m-scasserra/TrabajoFinal_MIoT/Hardware/LoRa-Monitor/3D Models/TYPE-C-31-M-12--3DModel-STEP-56544.STEP

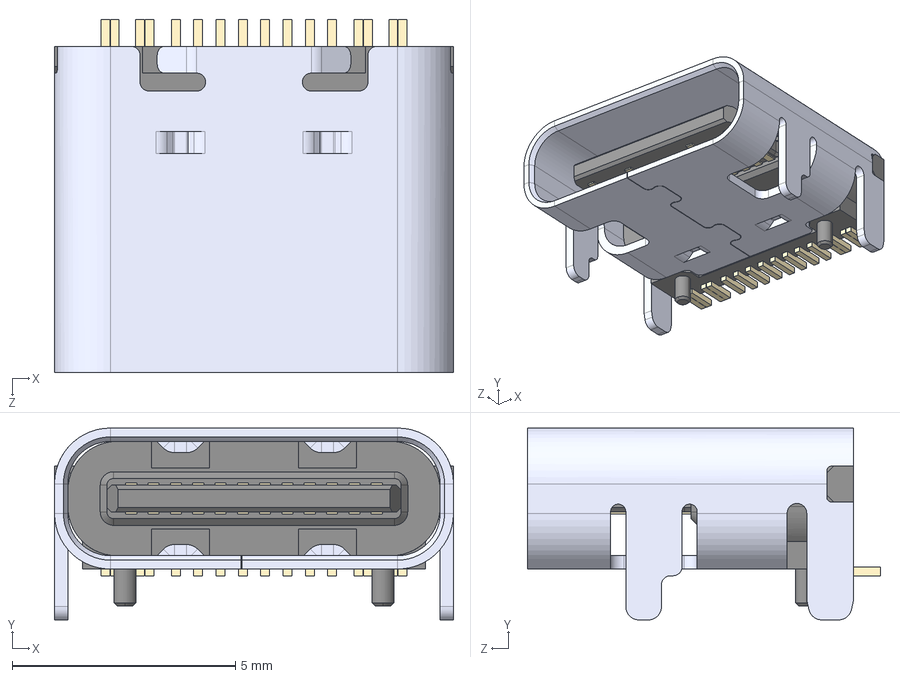
[picture p1: CAD file, 2026-07-15]
Hardware/LoRa-Monitor/3D Models/TYPE-C-31-M-12--3DModel-STEP-56544.STEP
8.94 x 4.30 x 7.90 mm
