m-scasserra/TrabajoFinal_MIoT/Hardware/LoRa-Monitor/3D Models/WE-GF_1210_2+%28rev1%29.stp

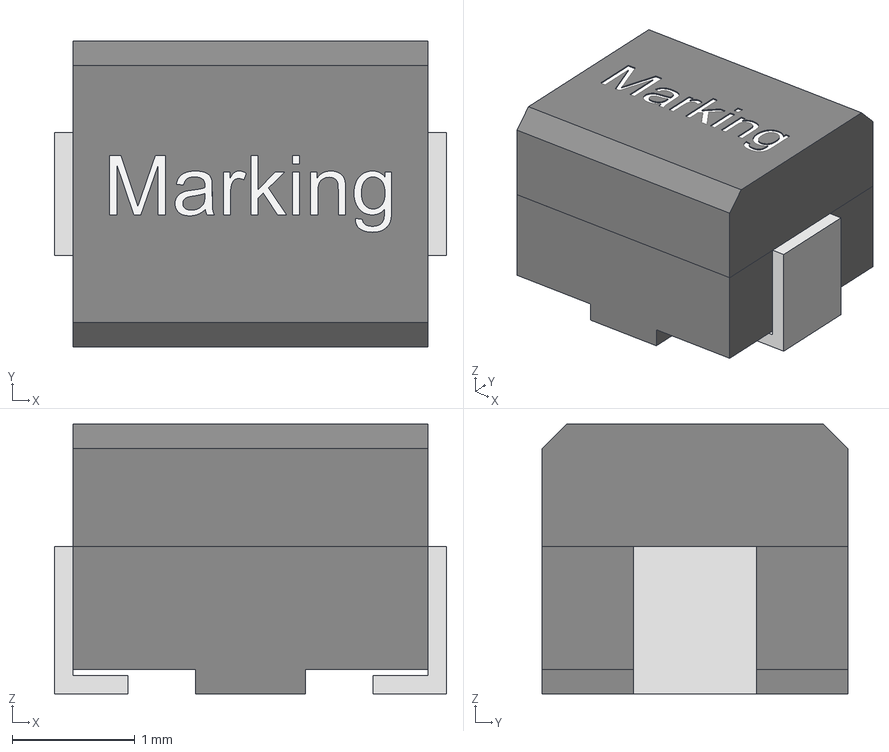
[picture p2: CAD file, 2026-07-15]
Hardware/LoRa-Monitor/3D Models/WE-GF_1210_2+%28rev1%29.stp
3.20 x 2.50 x 2.20 mm
Gehäuse
PIN
Deckel
