m-scasserra/TrabajoFinal_MIoT/Hardware/LoRa-Monitor/3D Models/SK6812MINI-012.step

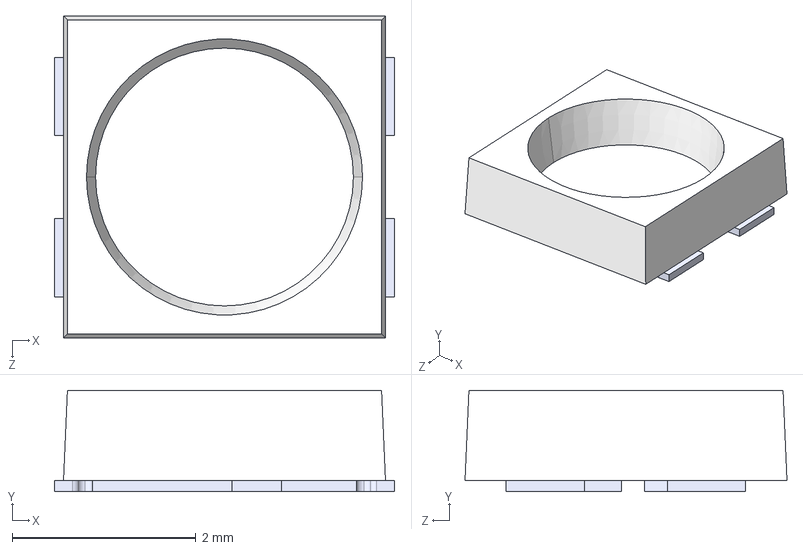
[picture p3: CAD file, 2026-06-10]
Hardware/LoRa-Monitor/3D Models/SK6812MINI-012.step
3.70 x 1.10 x 3.50 mm
