m-scasserra/TrabajoFinal_MIoT/Hardware/LoRa-Monitor/3D Models/E22-900M30S.step

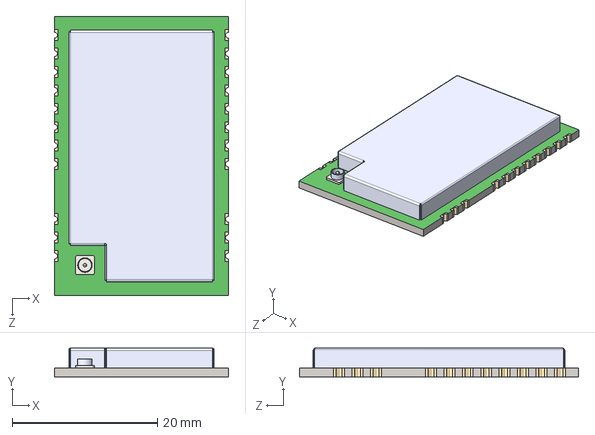
[picture p4: CAD file, 2026-06-10]
Hardware/LoRa-Monitor/3D Models/E22-900M30S.step
24.0 x 3.97 x 38.5 mm
