m-scasserra/TrabajoFinal_MIoT/Hardware/LoRa-Monitor/3D Models/ATM90E32AS-AU-R.step

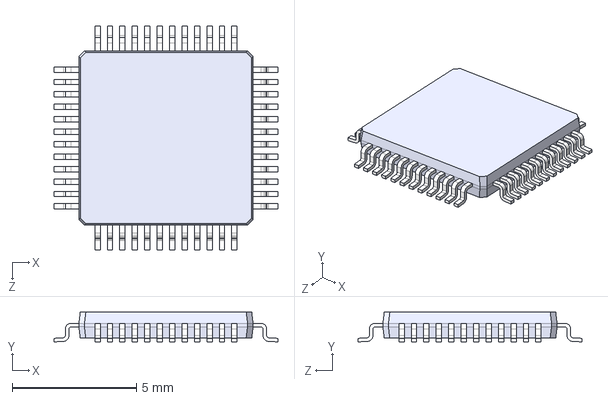
[picture p5: CAD file, 2026-06-10]
Hardware/LoRa-Monitor/3D Models/ATM90E32AS-AU-R.step
9.00 x 1.20 x 9.00 mm
