m-scasserra/TrabajoFinal_MIoT/Hardware/LoRa-Monitor/3D Models/IRM-05-5--3DModel-STEP-56544.STEP

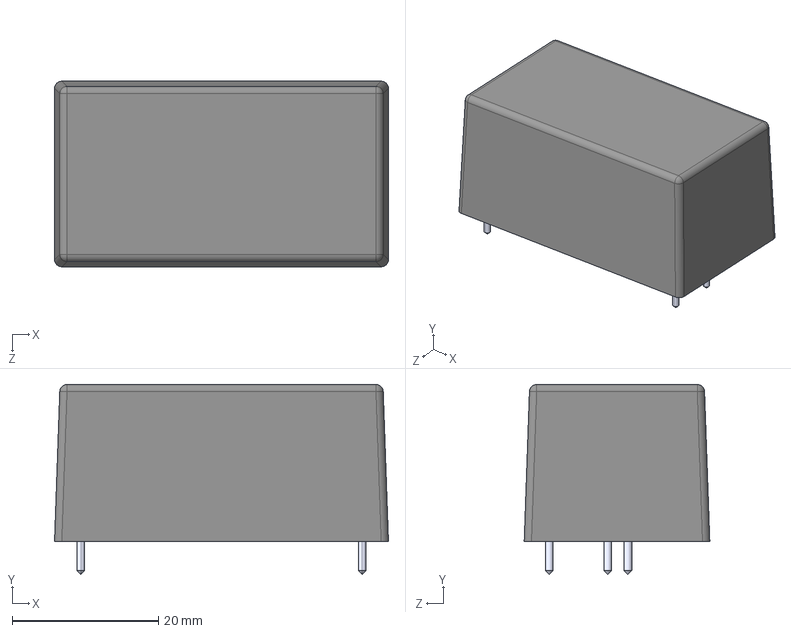
[picture p6: CAD file, 2026-06-09]
Hardware/LoRa-Monitor/3D Models/IRM-05-5--3DModel-STEP-56544.STEP
45.7 x 26.0 x 25.4 mm
