m-scasserra/TrabajoFinal_MIoT/Hardware/LoRa-Monitor/3D Models/472192001.stp

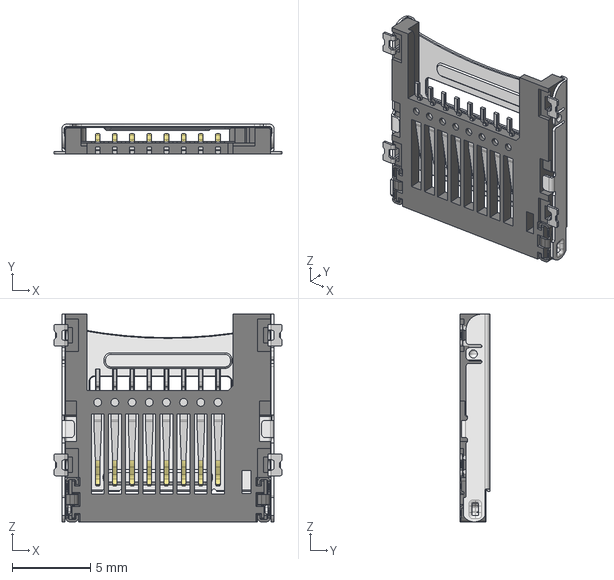
[picture p7: CAD file, 2026-07-15]
Hardware/LoRa-Monitor/3D Models/472192001.stp
14.6 x 1.90 x 13.3 mm
