m-scasserra/TrabajoFinal_MIoT/Hardware/LoRa-Monitor/3D Models/734120110.stp

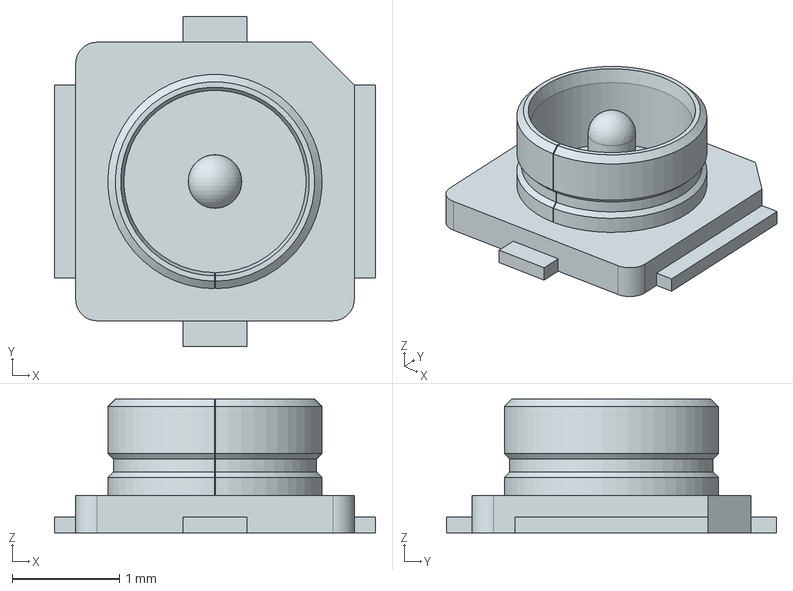
[picture p8: CAD file, 2026-07-15]
Hardware/LoRa-Monitor/3D Models/734120110.stp
3.00 x 3.08 x 1.25 mm
