m-scasserra/TrabajoFinal_MIoT/Hardware/LoRa-Monitor/3D Models/TPS63021DSJR.step

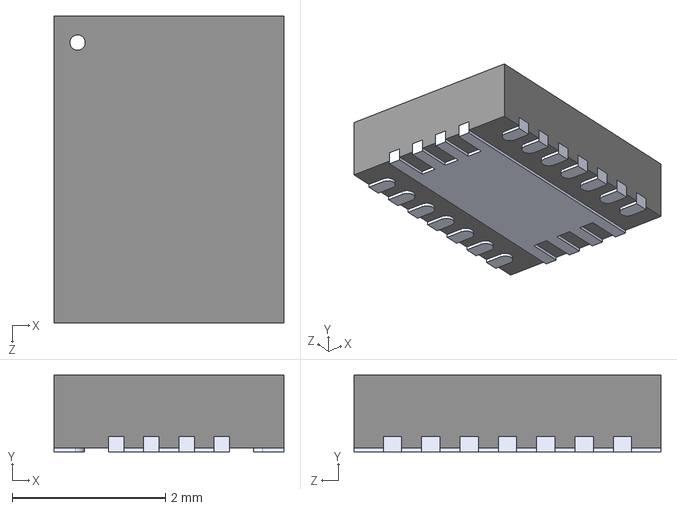
[picture p9: CAD file, 2026-06-09]
Hardware/LoRa-Monitor/3D Models/TPS63021DSJR.step
3.00 x 1.00 x 4.00 mm
