m-scasserra/TrabajoFinal_MIoT/Hardware/LoRa-Monitor/LoRa-Monitor.pdf

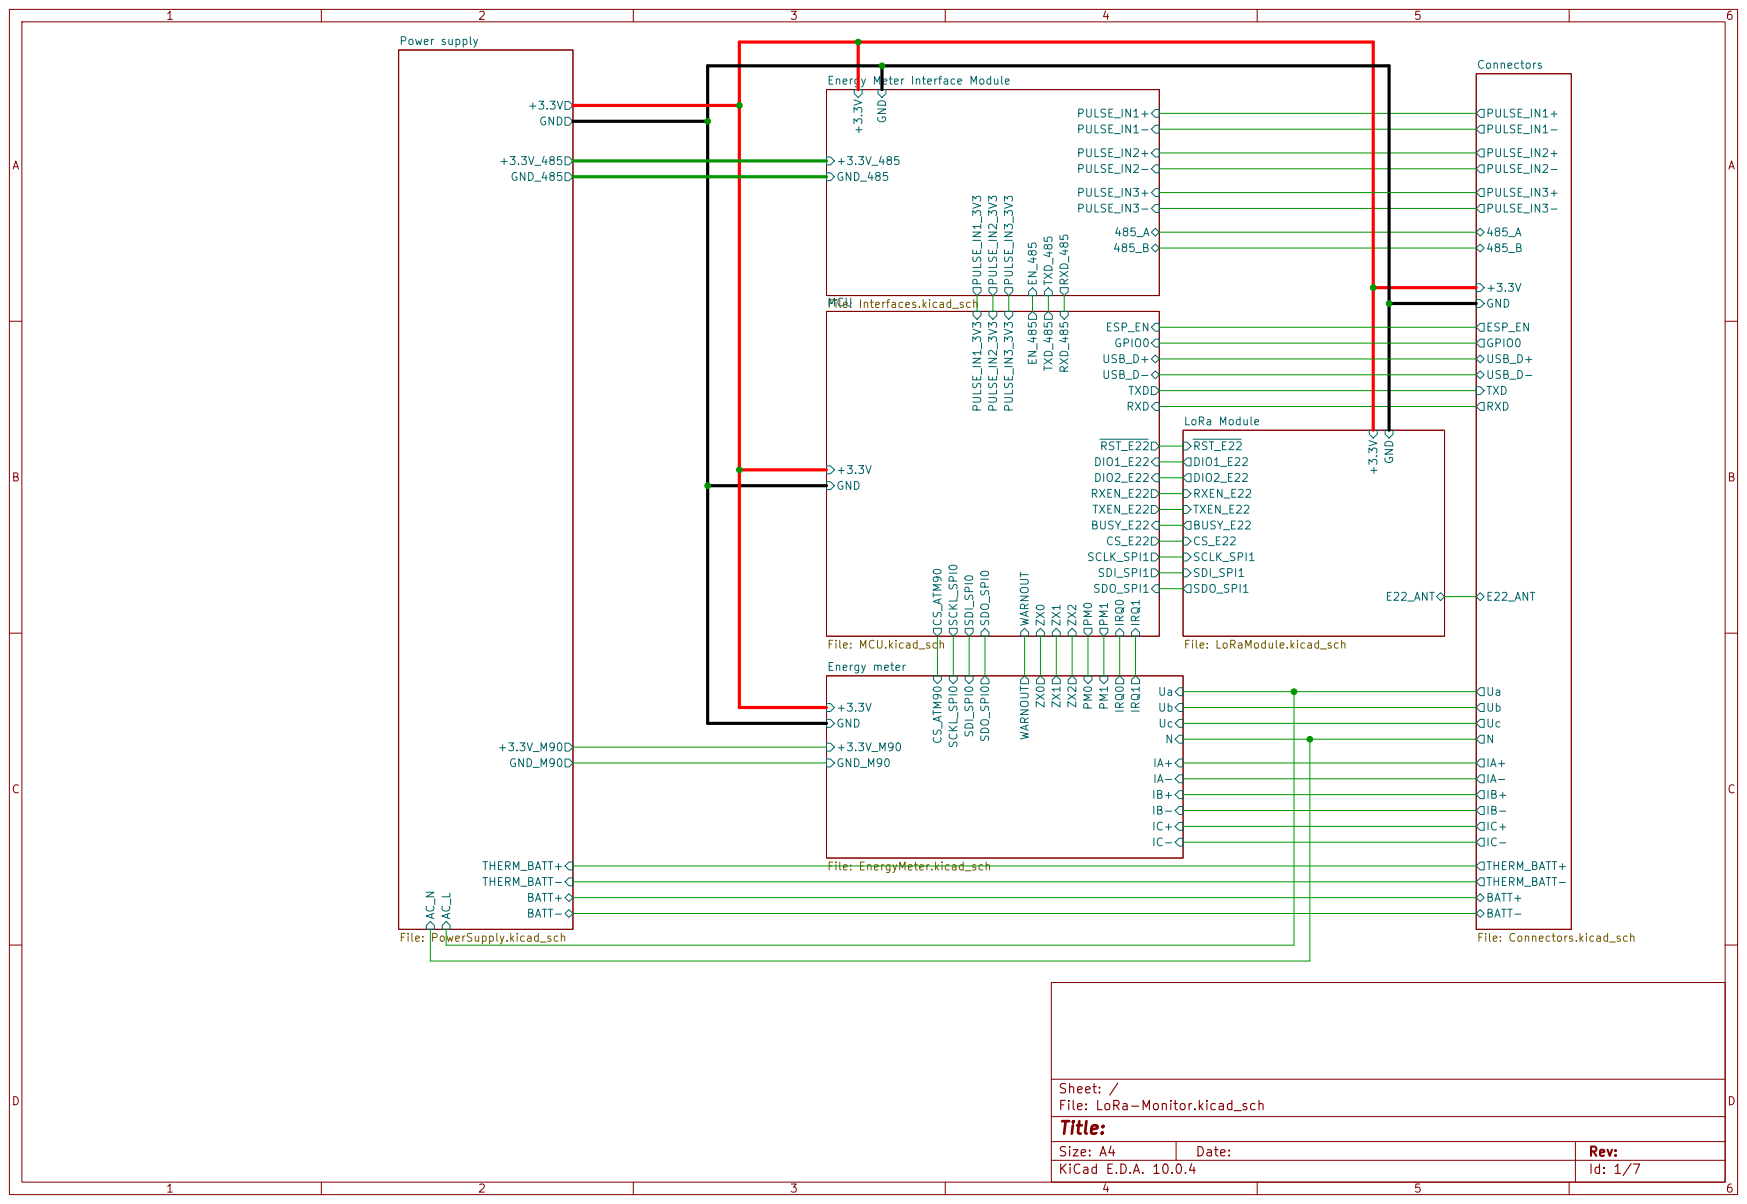
[picture p10: page 1]

Energy Meter Interface Module

Energy meter File: EnergyMeter.kicad_sch

Size: A4 | Rev:
KiCad E.D.A. 10.0.4 | Id: 1/7

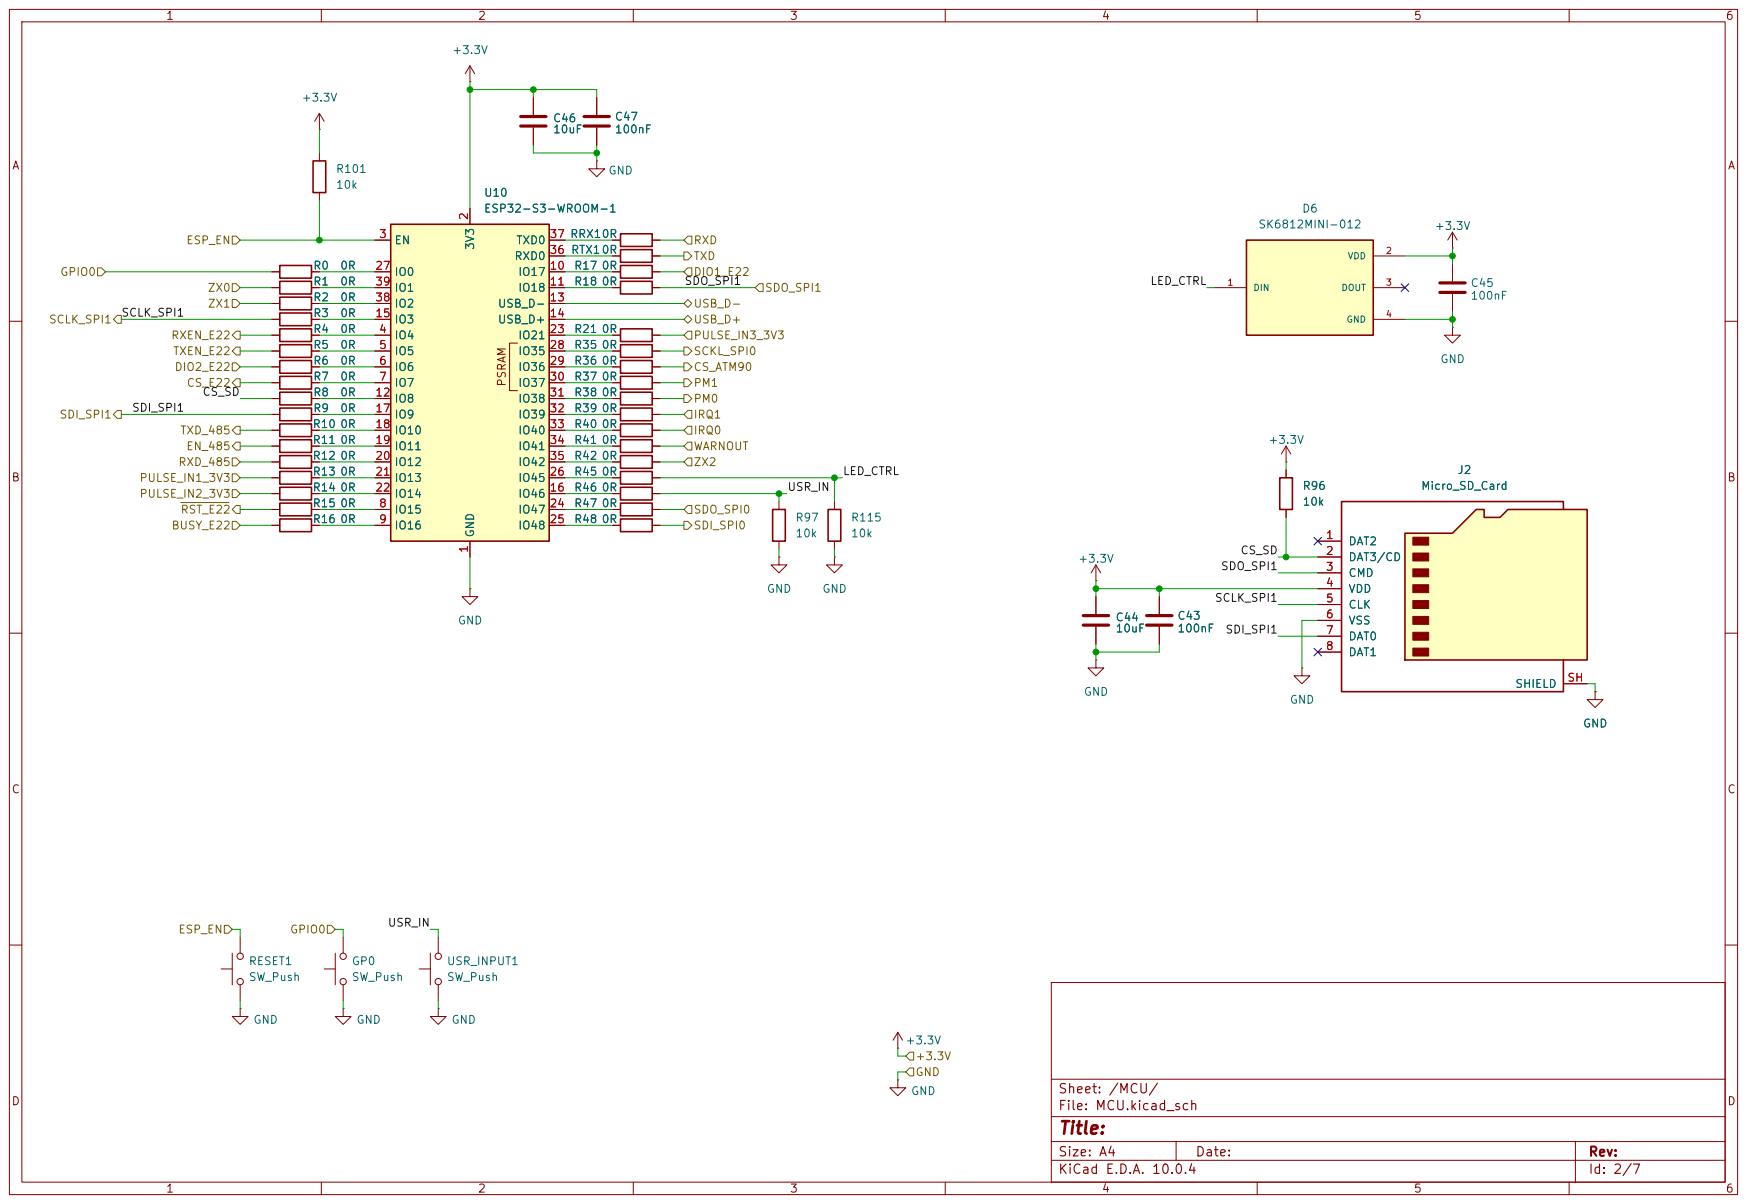
[picture p11: page 2]

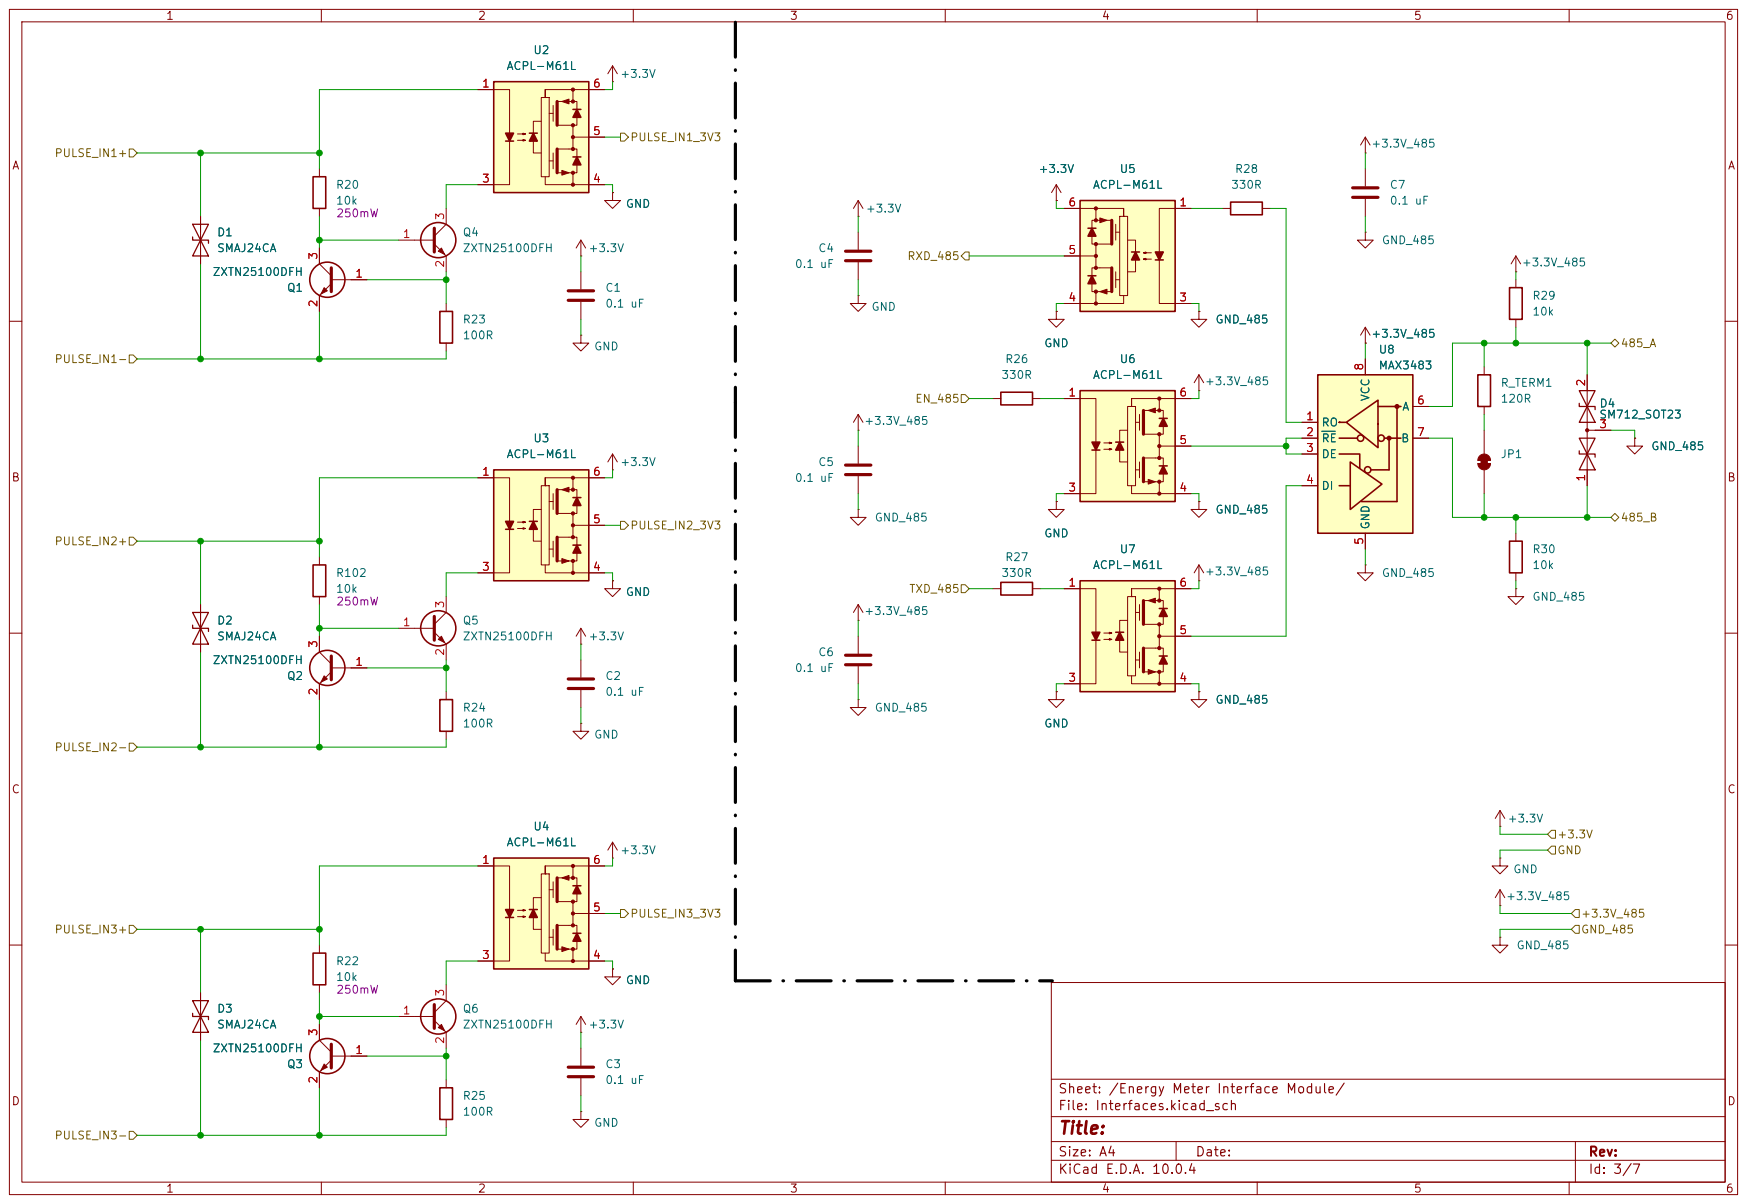
[picture p12: page 3]

Sheet: /Energy Meter Interface Module/
File: Interfaces.kicad_sch
Title:

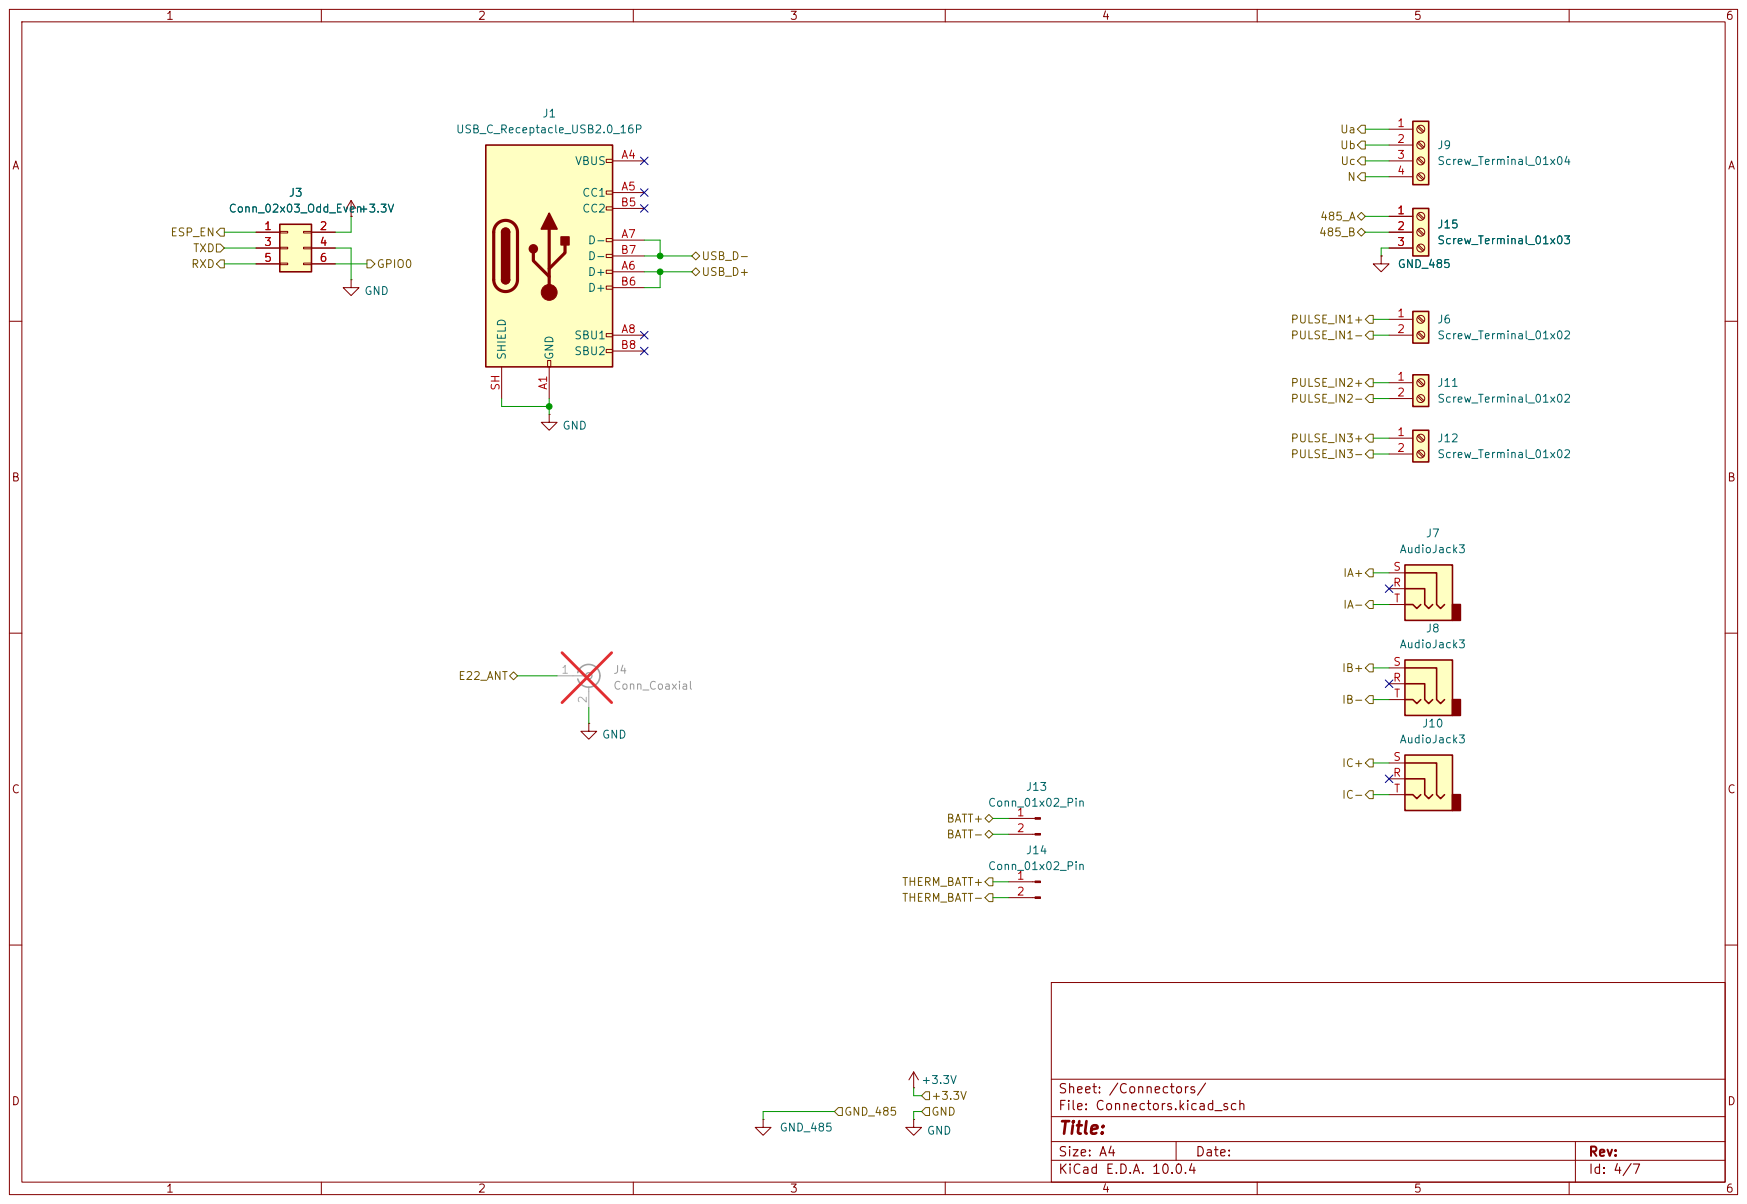
[picture p13: page 4]

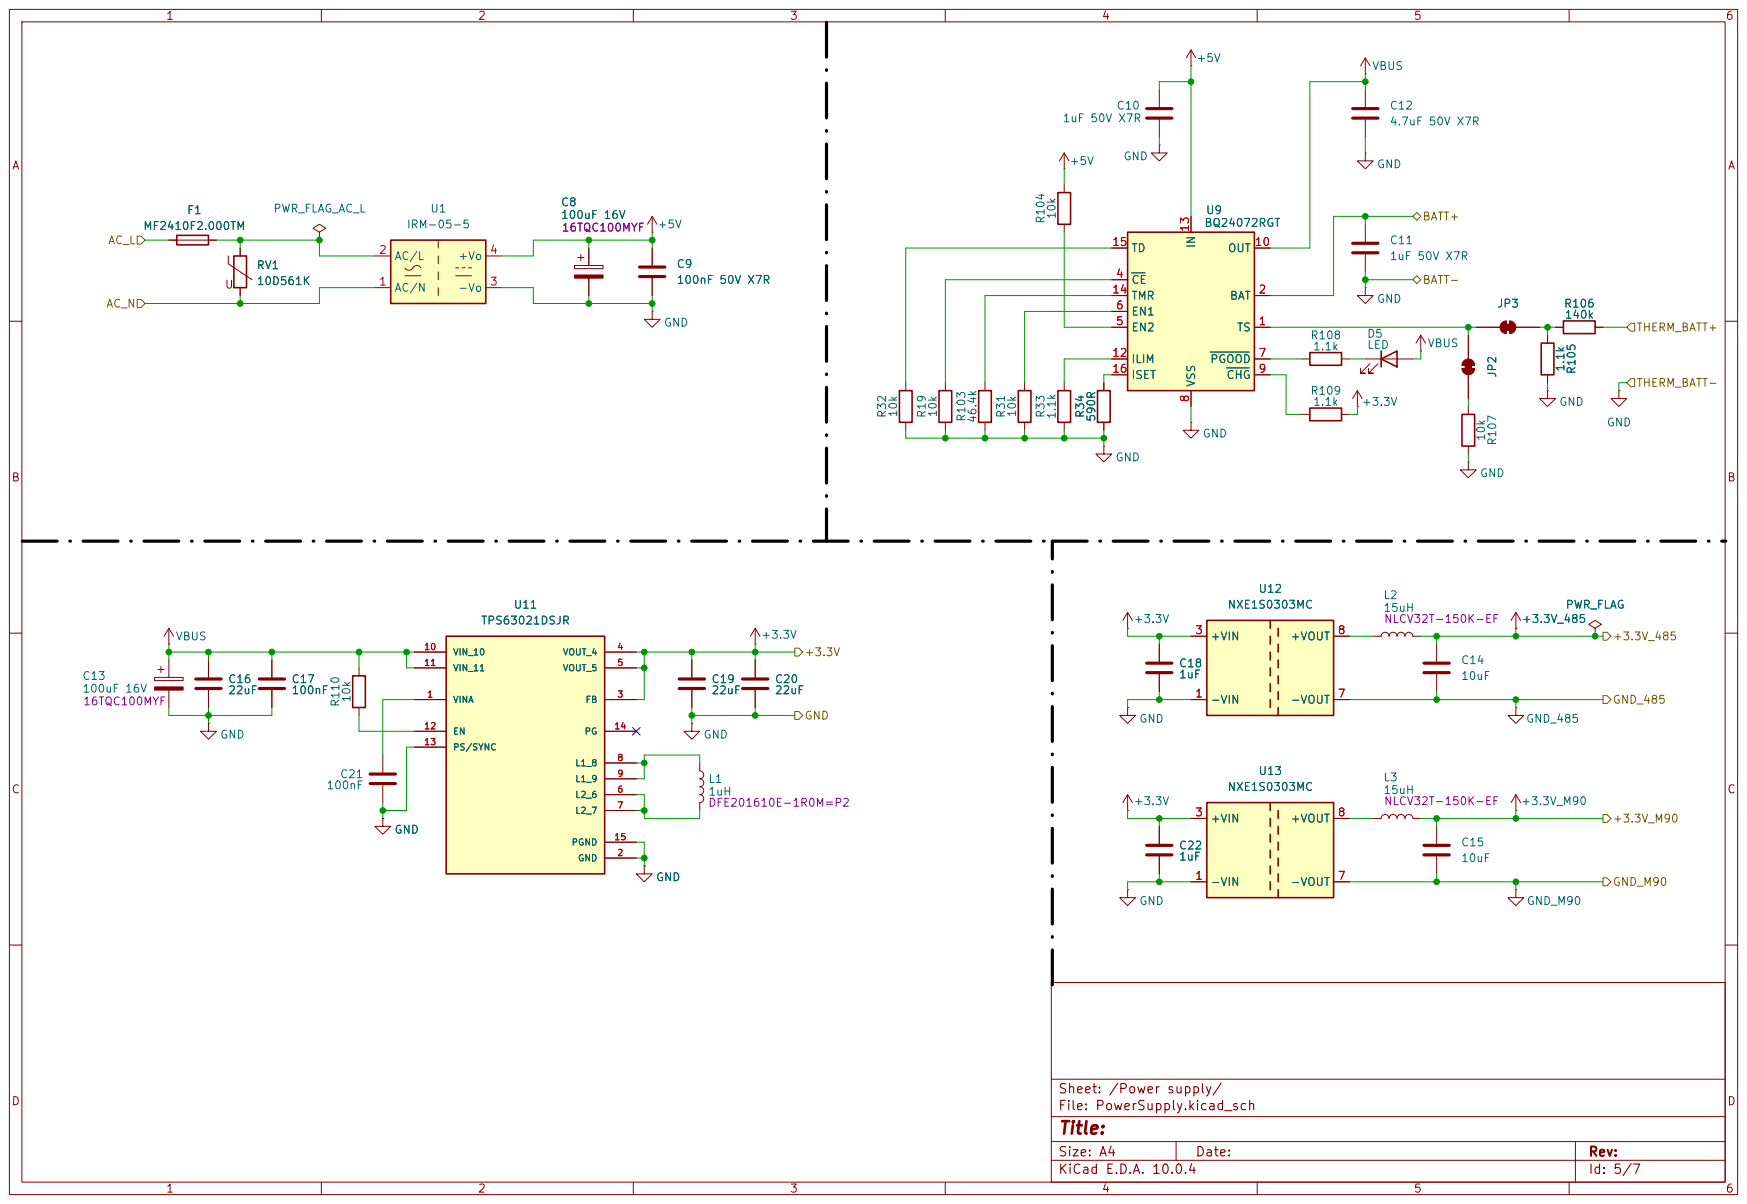
[picture p14: page 5]

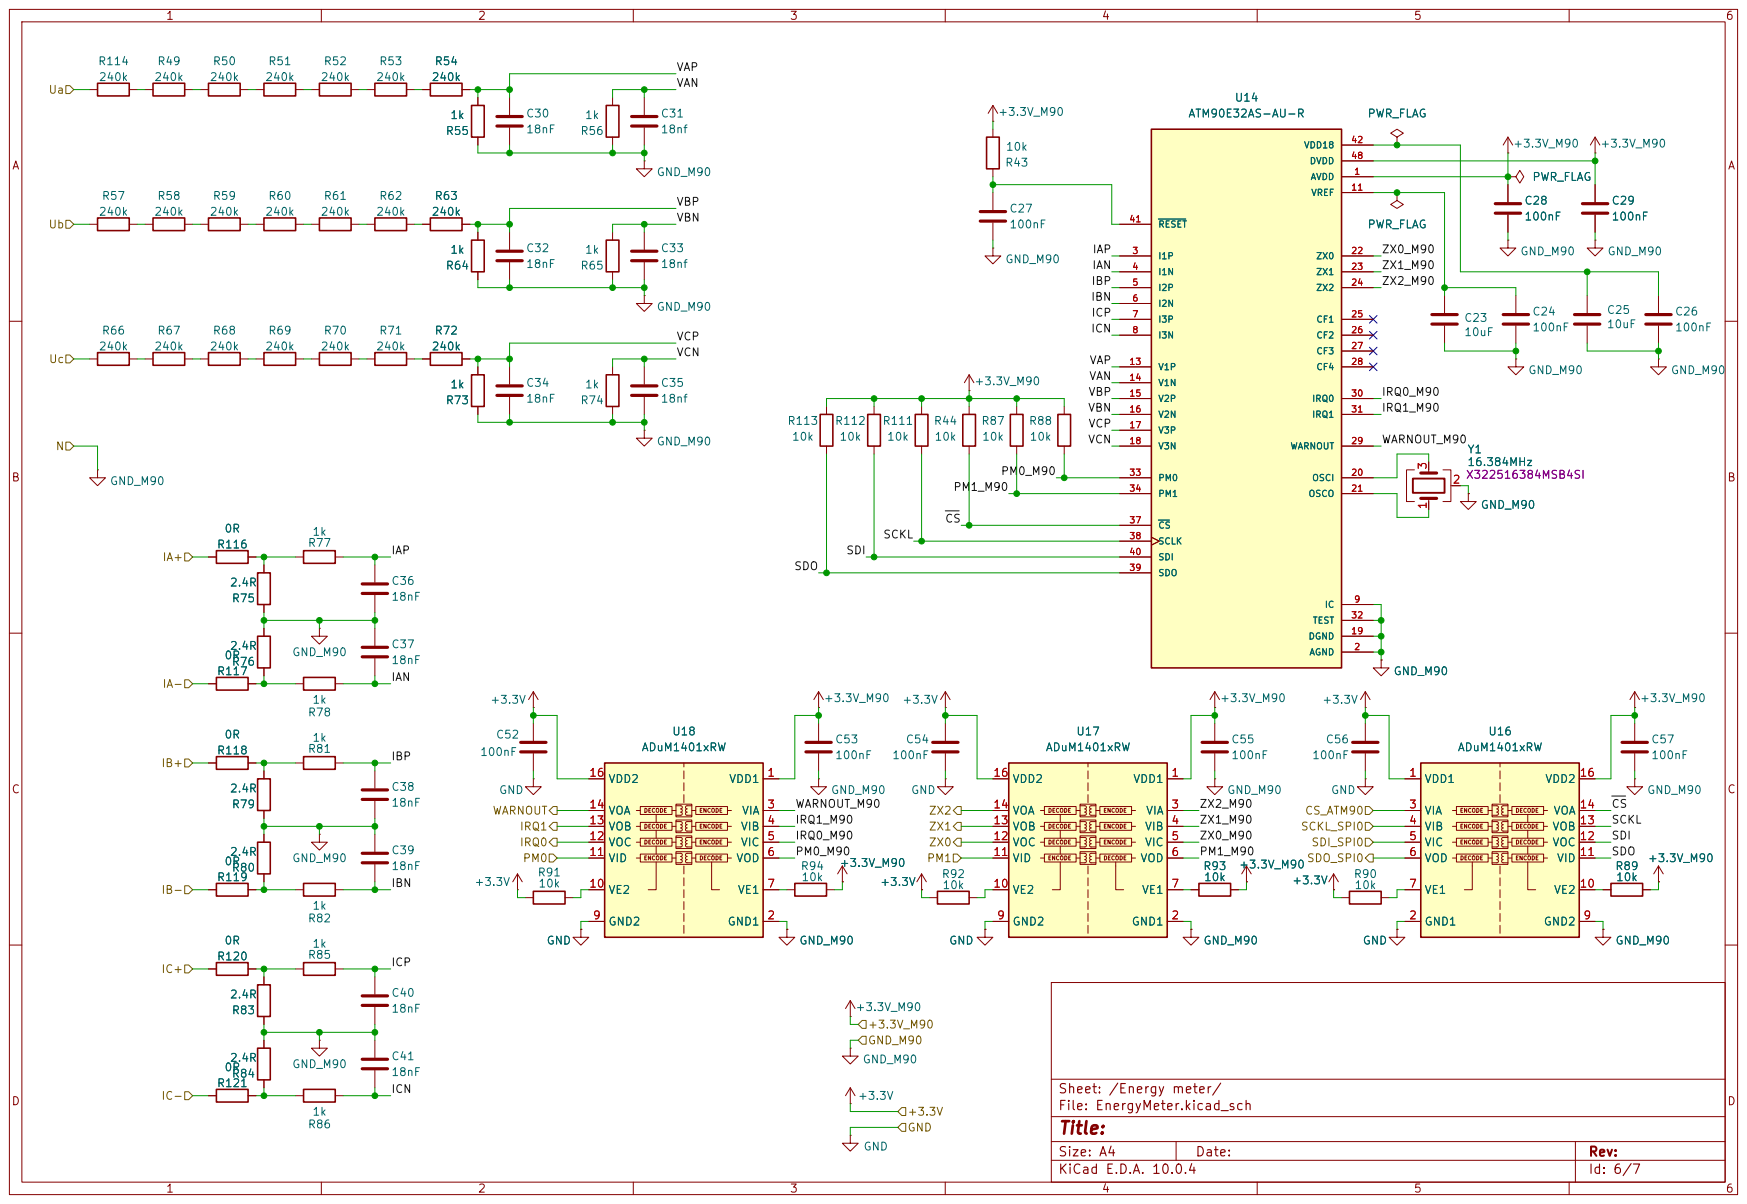
[picture p15: page 6]

VID 11 VOC 12 VOB 13 VOA 14

ENCODE DECODE DECODE DECODE DECODE

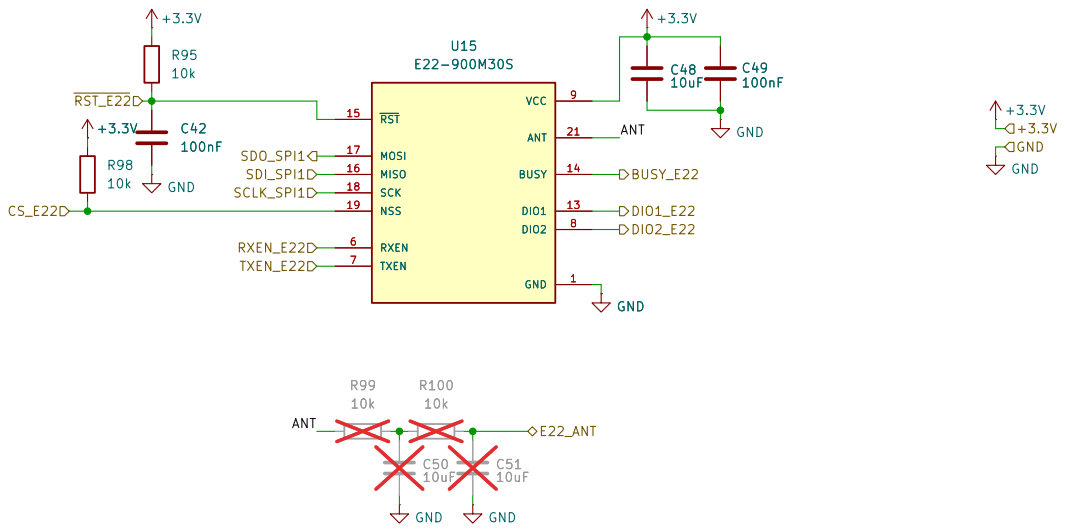
[picture p16: page 7]
