m-scasserra/TrabajoFinal_MIoT/Hardware/LoRa-Monitor/LoRa-Monitor.kicad_pcb

## KiCad design Hardware/LoRa-Monitor/LoRa-Monitor.kicad_pcb (2026-09-14)

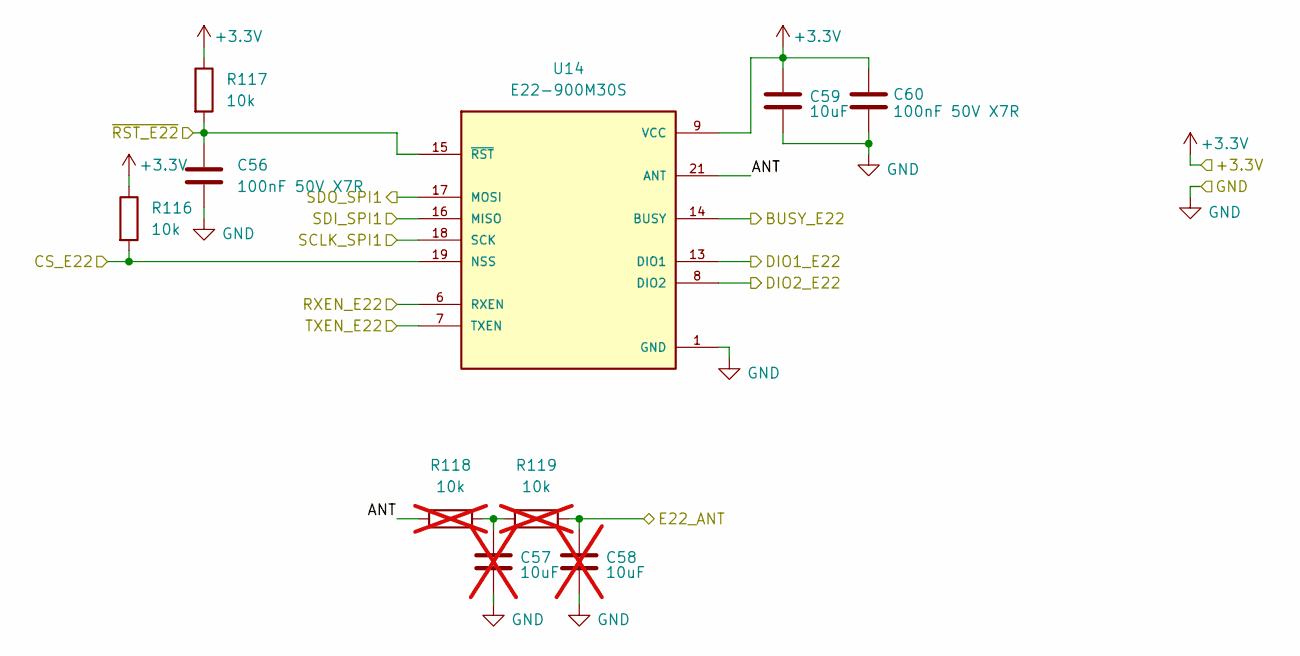
[picture p17: schematic LoRaModule.kicad_sch]

Parts:
C56, C60: 100nF 50V X7R; C_0805_2012Metric; LCSC Part # C49678
C57, C58: 10uF; C_0805_2012Metric; LCSC Part # C15850; not fitted
C59: 10uF; C_0805_2012Metric; LCSC Part # C15850
R116, R117: 10k; R_0805_2012Metric; LCSC Part # C17414
R118, R119: 10k; R_0805_2012Metric; LCSC Part # C17414; not fitted
U14: E22-900M30S; XCVR_E22-900M30S; LCSC Part # C411294

Connections:
+3.3V: C59.1, C60.1, R116.1, R117.1, U14.9 (VCC), U14.10 (VCC); also elsewhere on the board
/Connectors/E22_ANT: C58.1, R119.2; also elsewhere on the board
/LoRa Module/ANT: R118.1, U14.21 (ANT)
/LoRa Module/BUSY_E22: U14.14 (BUSY); also elsewhere on the board
/LoRa Module/CS_E22: R116.2, U14.19 (NSS); also elsewhere on the board
/LoRa Module/DIO1_E22: U14.13 (DIO1); also elsewhere on the board
/LoRa Module/DIO2_E22: U14.8 (DIO2); also elsewhere on the board
/LoRa Module/RXEN_E22: U14.6 (RXEN); also elsewhere on the board
/LoRa Module/TXEN_E22: U14.7 (TXEN); also elsewhere on the board
/LoRa Module/~RST_E22: C56.1, R117.2, U14.15 (~RST); also elsewhere on the board
/MCU/SCLK_SPI1: U14.18 (SCK); also elsewhere on the board
/MCU/SDI_SPI1: U14.16 (MISO); also elsewhere on the board
/MCU/SDO_SPI1: U14.17 (MOSI); also elsewhere on the board
GND: C56.2, C57.2, C58.2, C59.2, C60.2, U14.1 (GND), U14.2 (GND), U14.3 (GND), U14.4 (GND), U14.5 (GND), U14.11 (GND), U14.12 (GND), U14.20 (GND), U14.22 (GND); also elsewhere on the board
unnamed: C57.1, R118.2, R119.1

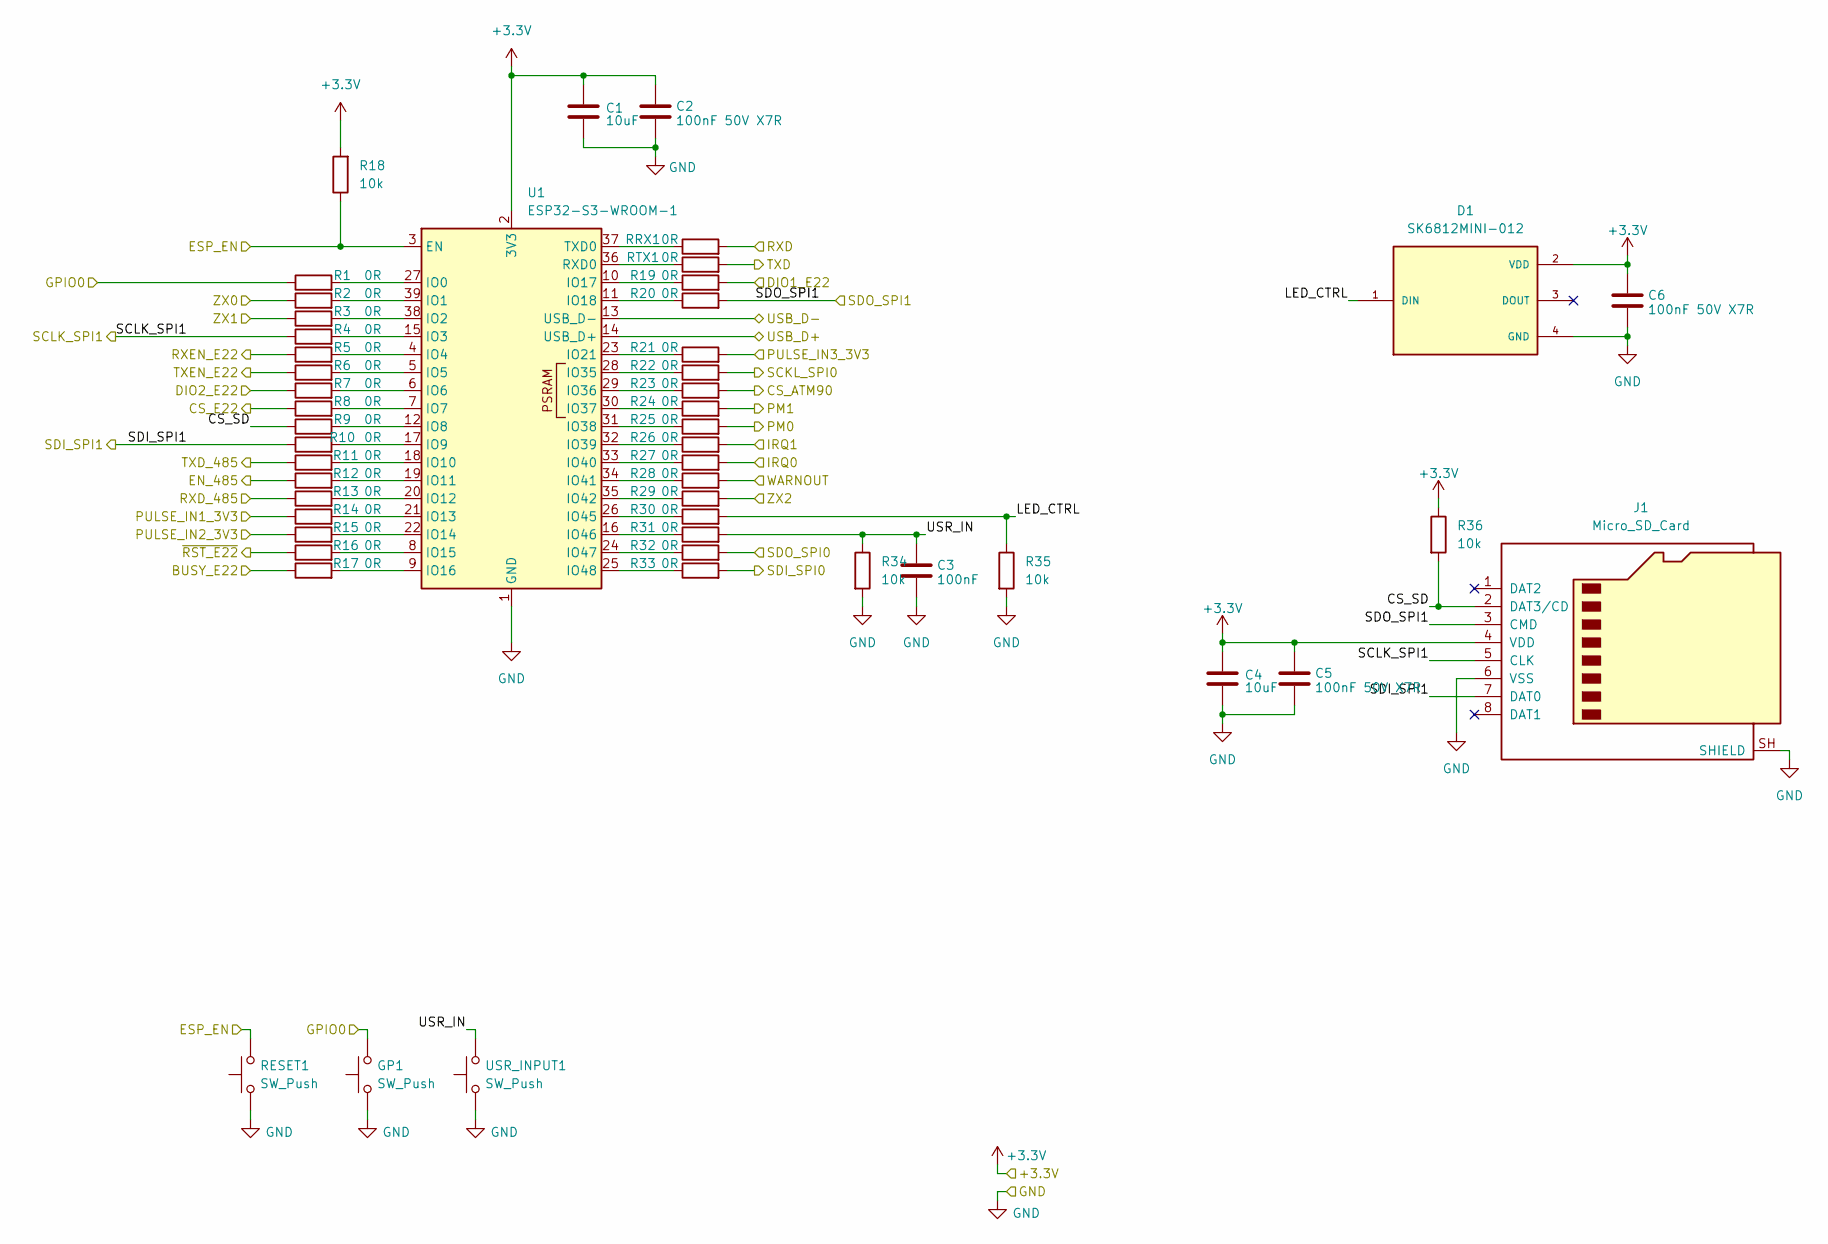
[picture p18: schematic MCU.kicad_sch]

Parts:
C1, C4: 10uF; C_0805_2012Metric; LCSC Part # C15850
C2, C5, C6: 100nF 50V X7R; C_0805_2012Metric; LCSC Part # C49678
C3: 100nF; C_0805_2012Metric; LCSC Part # C49678
D1: SK6812MINI-012; LED_SK6812MINI-012; LCSC Part # C2886570
GP1: SW_Push; SW_Push_1P1T_NO_CK_KMR2; LCSC Part # C72443
J1: Micro_SD_Card; microSD_HC_Molex_47219-2001; LCSC Part # C164170
R1, R2, R3, R4, R5, R6, R7, R8, R9, R10, R11, R12, R13, R14, R15, R16, R17, R19, R20, R21, R22, R23, R24, R25, R26, R27, R28, R29, R30, R31, R32, R33: 0R; R_0603_1608Metric; LCSC Part # C21189
R18, R34, R35, R36: 10k; R_0805_2012Metric; LCSC Part # C17414
RESET1: SW_Push; SW_Push_1P1T_NO_CK_KMR2; LCSC Part # C72443
RRX1: 0R; R_0603_1608Metric; LCSC Part # C21189
RTX1: 0R; R_0603_1608Metric; LCSC Part # C21189
U1: ESP32-S3-WROOM-1; LCSC Part # C2913205
USR_INPUT1: SW_Push; SW_Push_1P1T_NO_CK_KMR2; LCSC Part # C72443

Connections:
+3.3V: C1.1, C2.1, C4.1, C5.1, C6.1, D1.2 (VDD), J1.4 (VDD), R18.2, R36.1, U1.2 (3V3); also elsewhere on the board
/Connectors/ESP_EN: R18.1, RESET1.2, U1.3 (EN); also elsewhere on the board
/Connectors/GPIO0: GP1.2, R1.1; also elsewhere on the board
/Connectors/RXD: RRX1.2; also elsewhere on the board
/Connectors/TXD: RTX1.2; also elsewhere on the board
/Connectors/USB_D+: U1.14 (USB_D+); also elsewhere on the board
/Connectors/USB_D-: U1.13 (USB_D-); also elsewhere on the board
/Energy Meter Interface Module/EN_485: R12.1; also elsewhere on the board
/Energy Meter Interface Module/PULSE_IN1_3V3: R14.1; also elsewhere on the board
/Energy Meter Interface Module/PULSE_IN2_3V3: R15.1; also elsewhere on the board
/Energy Meter Interface Module/PULSE_IN3_3V3: R21.2; also elsewhere on the board
/Energy Meter Interface Module/RXD_485: R13.1; also elsewhere on the board
/Energy Meter Interface Module/TXD_485: R11.1; also elsewhere on the board
/Energy meter/CS_ATM90: R23.2; also elsewhere on the board
/Energy meter/IRQ0: R27.2; also elsewhere on the board
/Energy meter/IRQ1: R26.2; also elsewhere on the board
/Energy meter/PM0: R25.2; also elsewhere on the board
/Energy meter/PM1: R24.2; also elsewhere on the board
/Energy meter/SCKL_SPI0: R22.2; also elsewhere on the board
/Energy meter/SDI_SPI0: R33.2; also elsewhere on the board
/Energy meter/SDO_SPI0: R32.2; also elsewhere on the board
/Energy meter/WARNOUT: R28.2; also elsewhere on the board
/Energy meter/ZX0: R2.1; also elsewhere on the board
/Energy meter/ZX1: R3.1; also elsewhere on the board
/Energy meter/ZX2: R29.2; also elsewhere on the board
/LoRa Module/BUSY_E22: R17.1; also elsewhere on the board
/LoRa Module/CS_E22: R8.1; also elsewhere on the board
/LoRa Module/DIO1_E22: R19.2; also elsewhere on the board
/LoRa Module/DIO2_E22: R7.1; also elsewhere on the board
/LoRa Module/RXEN_E22: R5.1; also elsewhere on the board
/LoRa Module/TXEN_E22: R6.1; also elsewhere on the board
/LoRa Module/~RST_E22: R16.1; also elsewhere on the board
/MCU/CS_SD: J1.2 (DAT3/CD), R9.1, R36.2
/MCU/LED_CTRL: D1.1 (DIN), R30.2, R35.1
/MCU/SCLK_SPI1: J1.5 (CLK), R4.1; also elsewhere on the board
/MCU/SDI_SPI1: J1.7 (DAT0), R10.1; also elsewhere on the board
/MCU/SDO_SPI1: J1.3 (CMD), R20.2; also elsewhere on the board
/MCU/USR_IN: C3.1, R31.2, R34.1, USR_INPUT1.2
GND: C1.2, C2.2, C3.2, C4.2, C5.2, C6.2, D1.4 (GND), GP1.1, J1.6 (VSS), J1.SH (SHIELD), R34.2, R35.2, RESET1.1, U1.1 (GND), U1.40 (GND), U1.41 (GND), USR_INPUT1.1; also elsewhere on the board
unnamed: R1.2, U1.27 (IO0)
unnamed: R2.2, U1.39 (IO1)
unnamed: R3.2, U1.38 (IO2)
unnamed: R4.2, U1.15 (IO3)
unnamed: R5.2, U1.4 (IO4)
unnamed: R6.2, U1.5 (IO5)
unnamed: R7.2, U1.6 (IO6)
unnamed: R8.2, U1.7 (IO7)
unnamed: R9.2, U1.12 (IO8)
unnamed: R10.2, U1.17 (IO9)
unnamed: R11.2, U1.18 (IO10)
unnamed: R12.2, U1.19 (IO11)
unnamed: R13.2, U1.20 (IO12)
unnamed: R14.2, U1.21 (IO13)
unnamed: R15.2, U1.22 (IO14)
unnamed: R16.2, U1.8 (IO15)
unnamed: R17.2, U1.9 (IO16)
unnamed: R19.1, U1.10 (IO17)
unnamed: R20.1, U1.11 (IO18)
unnamed: R21.1, U1.23 (IO21)
unnamed: R22.1, U1.28 (IO35)
unnamed: R23.1, U1.29 (IO36)
unnamed: R24.1, U1.30 (IO37)
unnamed: R25.1, U1.31 (IO38)
unnamed: R26.1, U1.32 (IO39)
unnamed: R27.1, U1.33 (IO40)
unnamed: R28.1, U1.34 (IO41)
unnamed: R29.1, U1.35 (IO42)
unnamed: R30.1, U1.26 (IO45)
unnamed: R31.1, U1.16 (IO46)
unnamed: R32.1, U1.24 (IO47)
unnamed: R33.1, U1.25 (IO48)
unnamed: RTX1.1, U1.36 (RXD0)
unnamed: RRX1.1, U1.37 (TXD0)

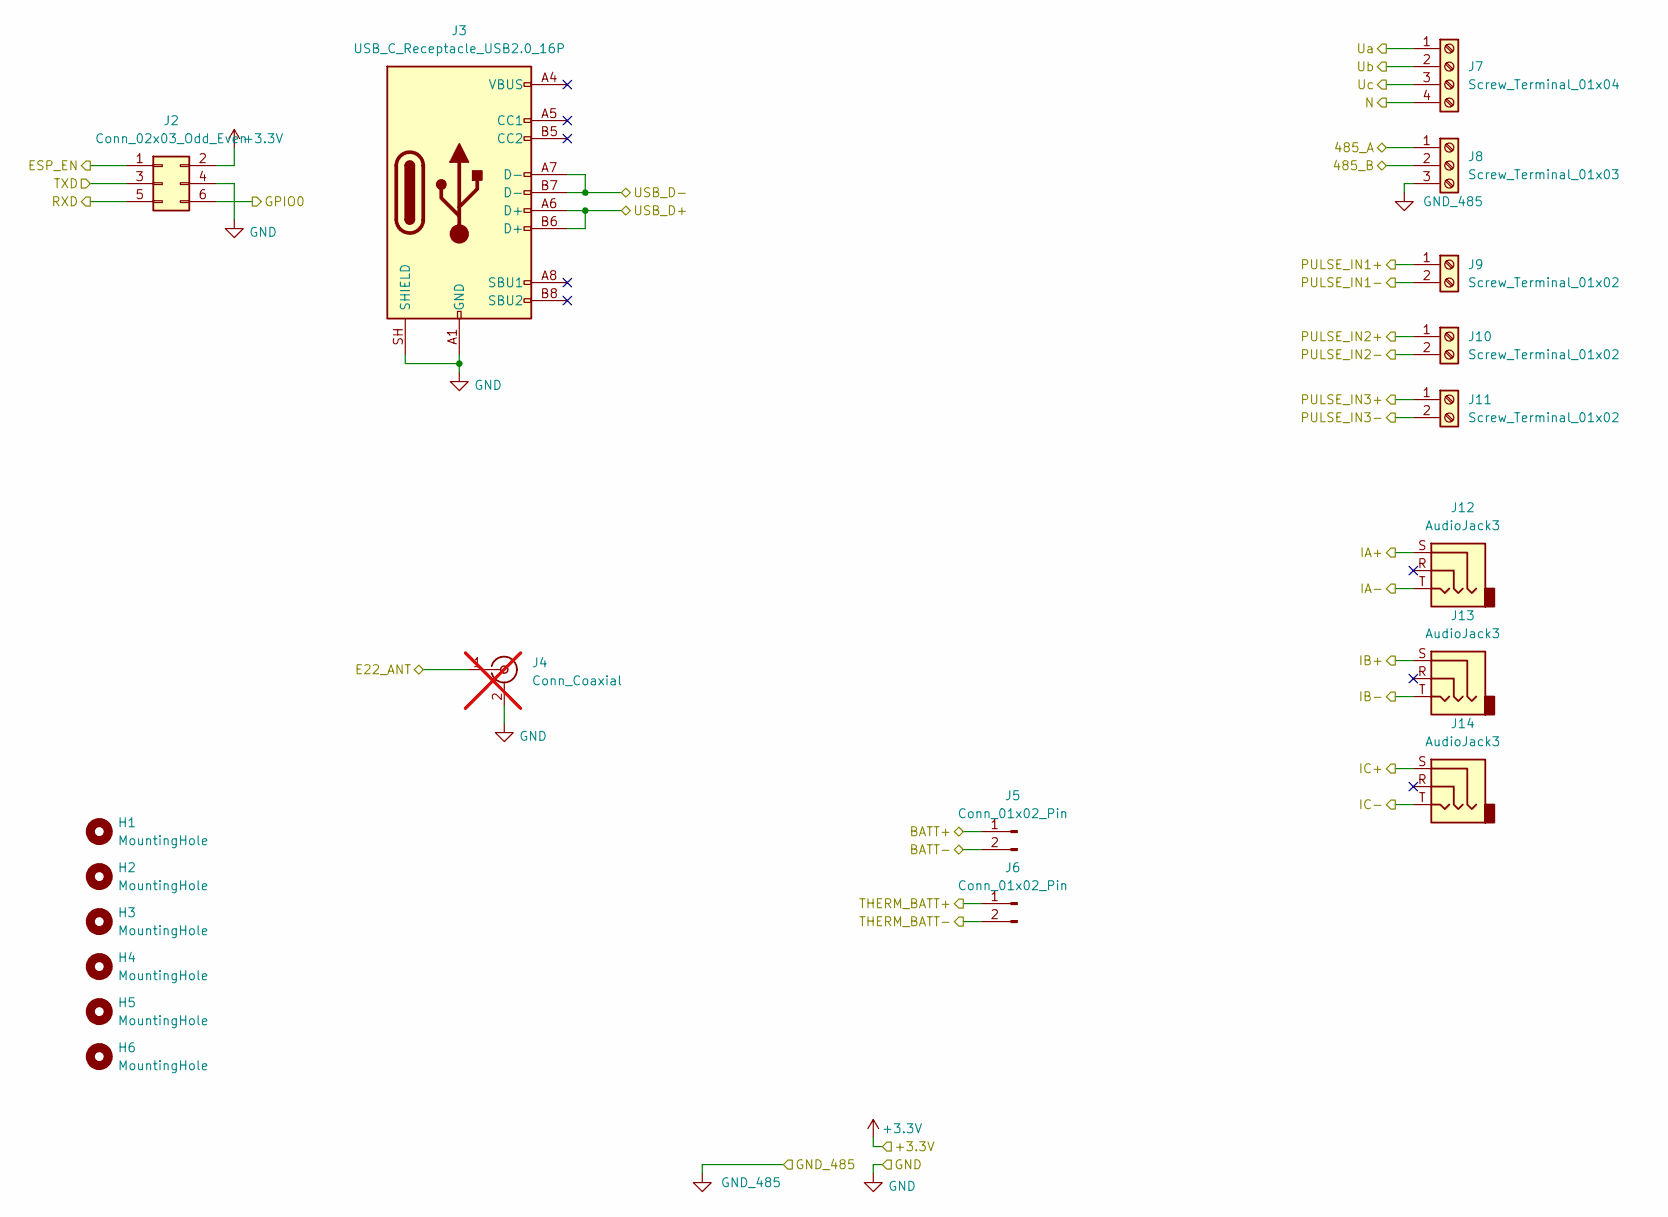
[picture p19: schematic Connectors.kicad_sch]

Parts:
H1, H2, H3, H4, H5, H6: MountingHole; MountingHole_3.2mm_M3_DIN965
J2: Conn_02x03_Odd_Even; PinHeader_2x03_P2.54mm_Vertical
J3: USB_C_Receptacle_USB2.0_16P; USB_C_Receptacle_HRO_TYPE-C-31-M-12; LCSC Part # C165948
J4: Conn_Coaxial; U.FL_Molex_MCRF_73412-0110_Vertical; LCSC Part # C434806; not fitted
J5, J6: Conn_01x02_Pin; JST_PH_B2B-PH-K_1x02_P2.00mm_Vertical; LCSC Part # C131337
J7: Screw_Terminal_01x04; TerminalBlock_Phoenix_PT-1,5-4-5.0-H_1x04_P5.00mm_Horizontal; LCSC Part # C3817931
J8: Screw_Terminal_01x03; TerminalBlock_Phoenix_PT-1,5-3-5.0-H_1x03_P5.00mm_Horizontal; LCSC Part # C3816891
J9, J10, J11: Screw_Terminal_01x02; TerminalBlock_Phoenix_PT-1,5-2-5.0-H_1x02_P5.00mm_Horizontal; LCSC Part # C3819953
J12, J13, J14: AudioJack3; Jack_3.5mm_CUI_SJ1-3523N_Horizontal; LCSC Part # C20182914

Connections:
+3.3V: J2.2; also elsewhere on the board
/Connectors/485_A: J8.1; also elsewhere on the board
/Connectors/485_B: J8.2; also elsewhere on the board
/Connectors/BATT+: J5.1; also elsewhere on the board
/Connectors/E22_ANT: J4.1 (In); also elsewhere on the board
/Connectors/ESP_EN: J2.1; also elsewhere on the board
/Connectors/GPIO0: J2.6; also elsewhere on the board
/Connectors/IA+: J12.S; also elsewhere on the board
/Connectors/IA-: J12.T; also elsewhere on the board
/Connectors/IB+: J13.S; also elsewhere on the board
/Connectors/IB-: J13.T; also elsewhere on the board
/Connectors/IC+: J14.S; also elsewhere on the board
/Connectors/IC-: J14.T; also elsewhere on the board
/Connectors/PULSE_IN1+: J9.1; also elsewhere on the board
/Connectors/PULSE_IN1-: J9.2; also elsewhere on the board
/Connectors/PULSE_IN2+: J10.1; also elsewhere on the board
/Connectors/PULSE_IN2-: J10.2; also elsewhere on the board
/Connectors/PULSE_IN3+: J11.1; also elsewhere on the board
/Connectors/PULSE_IN3-: J11.2; also elsewhere on the board
/Connectors/RXD: J2.5; also elsewhere on the board
/Connectors/THERM_BATT+: J6.1; also elsewhere on the board
/Connectors/TXD: J2.3; also elsewhere on the board
/Connectors/USB_D+: J3.A6 (D+), J3.B6 (D+); also elsewhere on the board
/Connectors/USB_D-: J3.A7 (D-), J3.B7 (D-); also elsewhere on the board
/Connectors/Ua: J7.1; also elsewhere on the board
/Connectors/Ub: J7.2; also elsewhere on the board
/Connectors/Uc: J7.3; also elsewhere on the board
GND: J2.4, J3.A1 (GND), J3.A12 (GND), J3.B1 (GND), J3.B12 (GND), J3.SH (SHIELD), J4.2 (Ext), J5.2, J6.2; also elsewhere on the board
GND_485: J8.3; also elsewhere on the board
GND_M90: J7.4; also elsewhere on the board

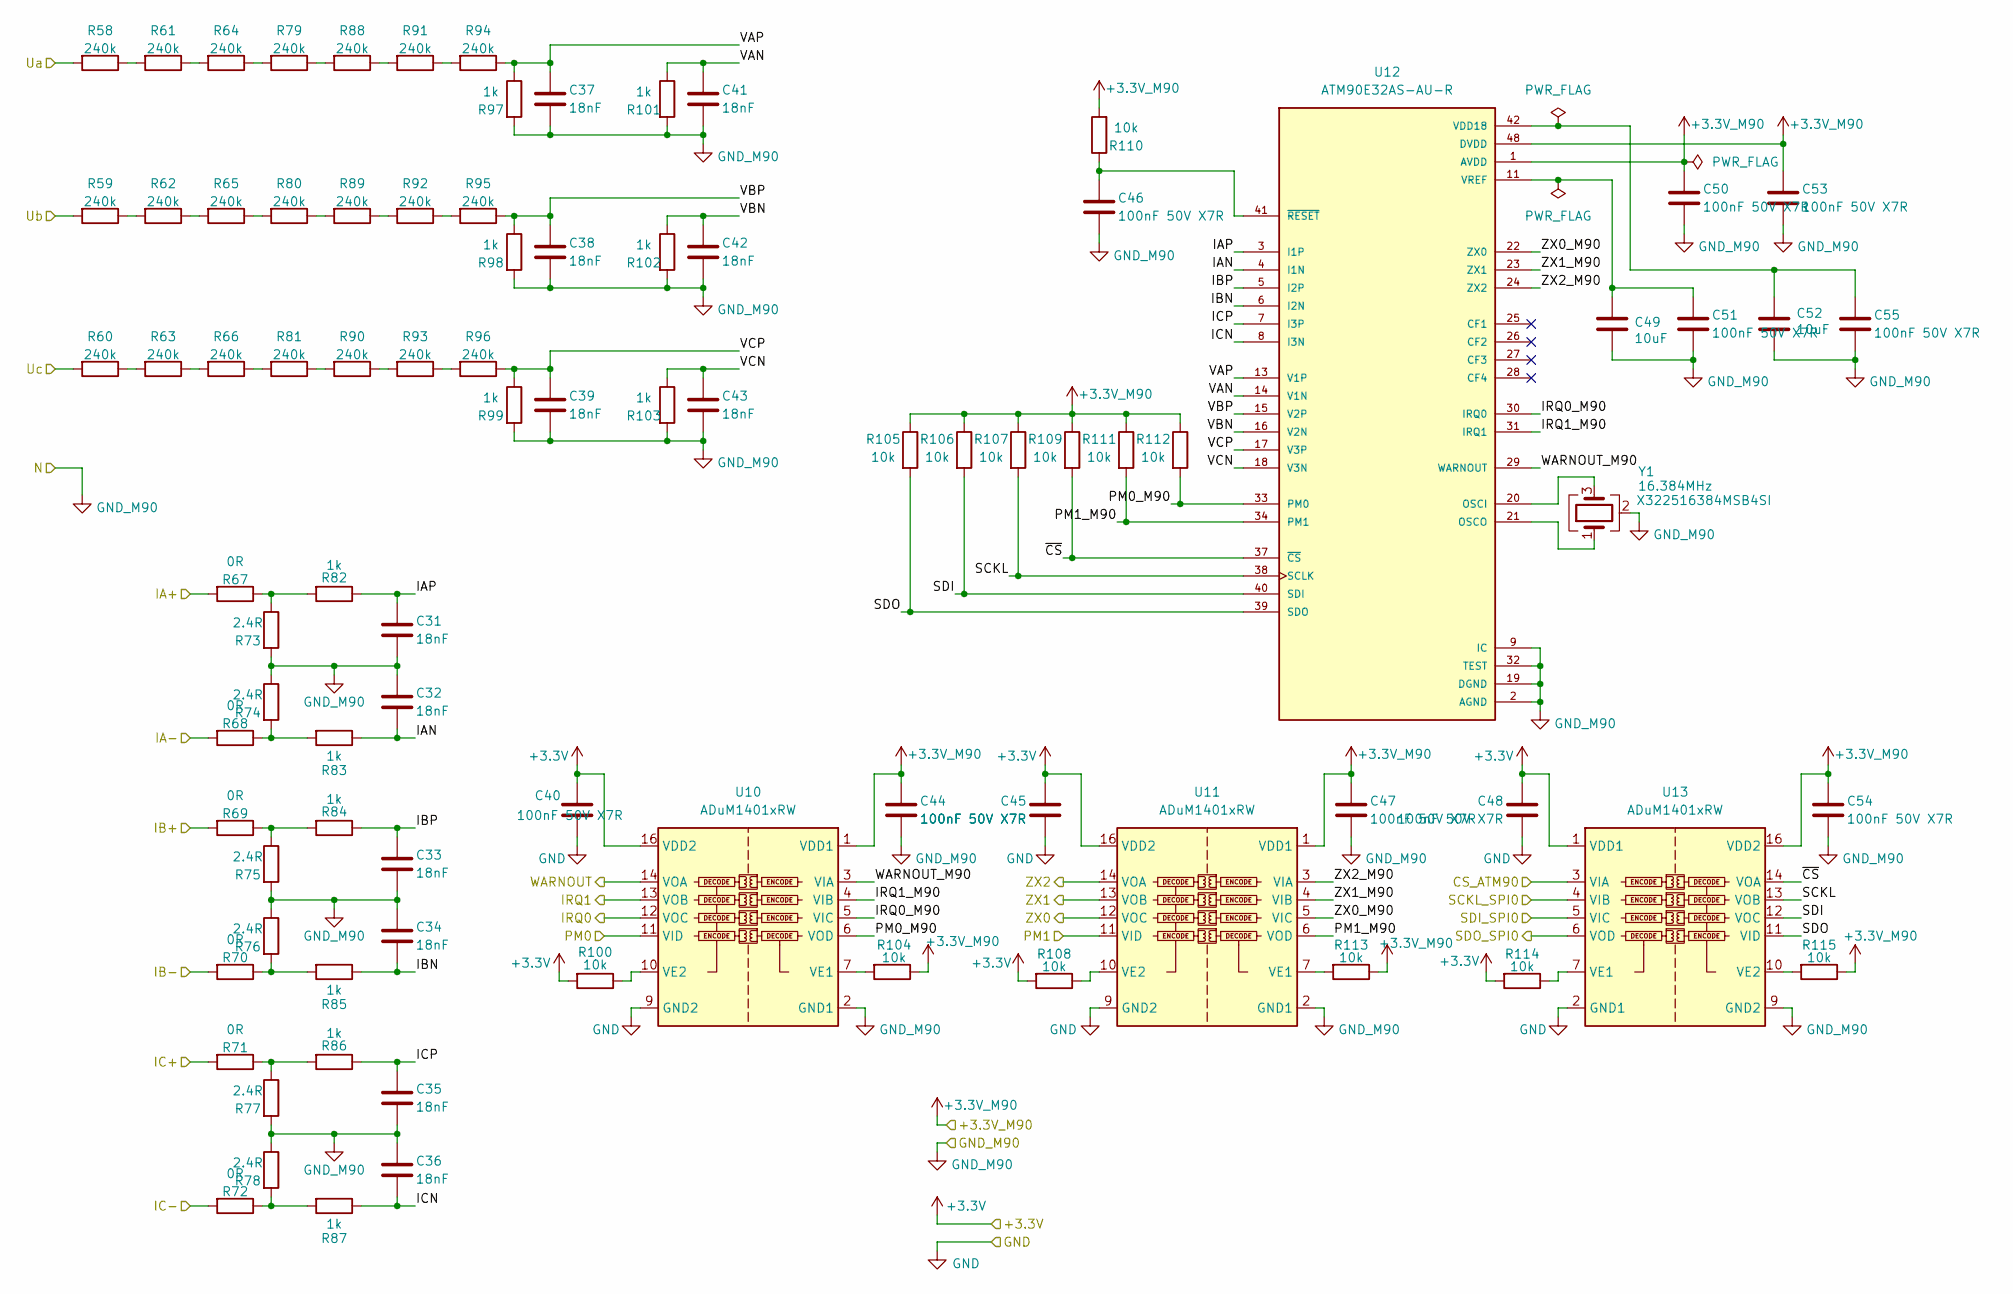
[picture p20: schematic EnergyMeter.kicad_sch]

Parts:
C31, C32, C33, C34, C35, C36, C37, C38, C39, C41, C42, C43: 18nF; C_0805_2012Metric; LCSC Part # C1723
C40, C44, C45, C46, C47, C48, C50, C51, C53, C54, C55: 100nF 50V X7R; C_0805_2012Metric; LCSC Part # C49678
C49, C52: 10uF; C_0805_2012Metric; LCSC Part # C15850
R58, R59, R60, R61, R62, R63, R64, R65, R66, R79, R80, R81, R88, R89, R90, R91, R92, R93, R94, R95, R96: 240k; R_1206_3216Metric; LCSC Part # C18001
R67, R68, R69, R70, R71, R72: 0R; R_0805_2012Metric; LCSC Part # C17477
R73, R74, R75, R76, R77, R78: 2.4R; R_0805_2012Metric; LCSC Part # C17528
R82, R83, R84, R85, R86, R87, R97, R98, R99, R101, R102, R103: 1k; R_0805_2012Metric; LCSC Part # C17513
R100, R104, R105, R106, R107, R108, R109, R110, R111, R112, R113, R114, R115: 10k; R_0805_2012Metric; LCSC Part # C17414
U10, U11, U13: ADuM1401xRW; SOIC-16W_7.5x10.3mm_P1.27mm; LCSC Part # C91762
U12: ATM90E32AS-AU-R; QFP50P900X900X120-48N; LCSC Part # C177153
Y1: 16.384MHz; Crystal_SMD_3225-4Pin_3.2x2.5mm; Part # X322516384MSB4SI; LCSC Part # C13739

Connections:
+3.3V: C40.1, C45.1, C48.1, R100.2, R108.2, R114.2, U10.16 (VDD2), U11.16 (VDD2), U13.1 (VDD1); also elsewhere on the board
+3.3V_M90: C44.1, C47.1, C50.1, C53.1, C54.1, R104.1, R105.1, R106.1, R107.1, R109.1, R110.2, R111.1, R112.1, R113.1, R115.1, U10.1 (VDD1), U11.1 (VDD1), U12.1 (AVDD), U12.48 (DVDD), U13.16 (VDD2); also elsewhere on the board
/Connectors/IA+: R67.2; also elsewhere on the board
/Connectors/IA-: R68.2; also elsewhere on the board
/Connectors/IB+: R69.2; also elsewhere on the board
/Connectors/IB-: R70.2; also elsewhere on the board
/Connectors/IC+: R71.2; also elsewhere on the board
/Connectors/IC-: R72.2; also elsewhere on the board
/Connectors/Ua: R58.2; also elsewhere on the board
/Connectors/Ub: R59.2; also elsewhere on the board
/Connectors/Uc: R60.2; also elsewhere on the board
/Energy meter/CS_ATM90: U13.3 (VIA); also elsewhere on the board
/Energy meter/IAN: C32.2, R83.1, U12.4 (I1N)
/Energy meter/IAP: C31.1, R82.1, U12.3 (I1P)
/Energy meter/IBN: C34.2, R85.1, U12.6 (I2N)
/Energy meter/IBP: C33.1, R84.1, U12.5 (I2P)
/Energy meter/ICN: C36.2, R87.1, U12.8 (I3N)
/Energy meter/ICP: C35.1, R86.1, U12.7 (I3P)
/Energy meter/IRQ0: U10.12 (VOC); also elsewhere on the board
/Energy meter/IRQ0_M90: U10.5 (VIC), U12.30 (IRQ0)
/Energy meter/IRQ1: U10.13 (VOB); also elsewhere on the board
/Energy meter/IRQ1_M90: U10.4 (VIB), U12.31 (IRQ1)
/Energy meter/PM0: U10.11 (VID); also elsewhere on the board
/Energy meter/PM0_M90: R112.2, U10.6 (VOD), U12.33 (PM0)
/Energy meter/PM1: U11.11 (VID); also elsewhere on the board
/Energy meter/PM1_M90: R111.2, U11.6 (VOD), U12.34 (PM1)
/Energy meter/SCKL: R107.2, U12.38 (SCLK), U13.13 (VOB)
/Energy meter/SCKL_SPI0: U13.4 (VIB); also elsewhere on the board
/Energy meter/SDI: R106.2, U12.40 (SDI), U13.12 (VOC)
/Energy meter/SDI_SPI0: U13.5 (VIC); also elsewhere on the board
/Energy meter/SDO: R105.2, U12.39 (SDO), U13.11 (VID)
/Energy meter/SDO_SPI0: U13.6 (VOD); also elsewhere on the board
/Energy meter/VAN: C41.1, R101.1, U12.14 (V1N)
/Energy meter/VAP: C37.1, R94.1, R97.1, U12.13 (V1P)
/Energy meter/VBN: C42.1, R102.1, U12.16 (V2N)
/Energy meter/VBP: C38.1, R95.1, R98.1, U12.15 (V2P)
/Energy meter/VCN: C43.1, R103.1, U12.18 (V3N)
/Energy meter/VCP: C39.1, R96.1, R99.1, U12.17 (V3P)
/Energy meter/WARNOUT: U10.14 (VOA); also elsewhere on the board
/Energy meter/WARNOUT_M90: U10.3 (VIA), U12.29 (WARNOUT)
/Energy meter/ZX0: U11.12 (VOC); also elsewhere on the board
/Energy meter/ZX0_M90: U11.5 (VIC), U12.22 (ZX0)
/Energy meter/ZX1: U11.13 (VOB); also elsewhere on the board
/Energy meter/ZX1_M90: U11.4 (VIB), U12.23 (ZX1)
/Energy meter/ZX2: U11.14 (VOA); also elsewhere on the board
/Energy meter/ZX2_M90: U11.3 (VIA), U12.24 (ZX2)
/Energy meter/~CS: R109.2, U12.37 (~CS), U13.14 (VOA)
GND: C40.2, C45.2, C48.2, U10.9 (GND2), U10.15 (GND2), U11.9 (GND2), U11.15 (GND2), U13.2 (GND1), U13.8 (GND1); also elsewhere on the board
GND_M90: C31.2, C32.1, C33.2, C34.1, C35.2, C36.1, C37.2, C38.2, C39.2, C41.2, C42.2, C43.2, C44.2, C46.2, C47.2, C49.2, C50.2, C51.2, C52.2, C53.2, C54.2, C55.2, R73.2, R74.1, R75.2, R76.1, R77.2, R78.1, R97.2, R98.2, R99.2, R101.2, R102.2, R103.2, U10.2 (GND1), U10.8 (GND1), U11.2 (GND1), U11.8 (GND1), U12.2 (AGND), U12.9 (IC), U12.10 (IC), U12.12 (AGND), U12.19 (DGND), U12.32 (TEST), U12.36 (IC), U12.44 (DGND), U12.47 (DGND), U13.9 (GND2), U13.15 (GND2), Y1.2 (G), Y1.4 (G); also elsewhere on the board
unnamed: R58.1, R61.2
unnamed: R59.1, R62.2
unnamed: R60.1, R63.2
unnamed: R61.1, R64.2
unnamed: R62.1, R65.2
unnamed: R63.1, R66.2
unnamed: R64.1, R79.2
unnamed: R65.1, R80.2
unnamed: R66.1, R81.2
unnamed: R67.1, R73.1, R82.2
unnamed: R68.1, R74.2, R83.2
unnamed: R69.1, R75.1, R84.2
unnamed: R70.1, R76.2, R85.2
unnamed: R71.1, R77.1, R86.2
unnamed: R72.1, R78.2, R87.2
unnamed: R79.1, R88.2
unnamed: R80.1, R89.2
unnamed: R81.1, R90.2
unnamed: R88.1, R91.2
unnamed: R89.1, R92.2
unnamed: R90.1, R93.2
unnamed: R91.1, R94.2
unnamed: R92.1, R95.2
unnamed: R93.1, R96.2
unnamed: R104.2, U10.7 (VE1)
unnamed: R100.1, U10.10 (VE2)
unnamed: R113.2, U11.7 (VE1)
unnamed: R108.1, U11.10 (VE2)
unnamed: U12.20 (OSCI), Y1.3
unnamed: U12.21 (OSCO), Y1.1
unnamed: C49.1, C51.1, U12.11 (VREF)
unnamed: C46.1, R110.1, U12.41 (~RESET)
unnamed: R114.1, U13.7 (VE1)
unnamed: R115.2, U13.10 (VE2)
VDD18: C52.1, C55.1, U12.42 (VDD18), U12.43 (VDD18)

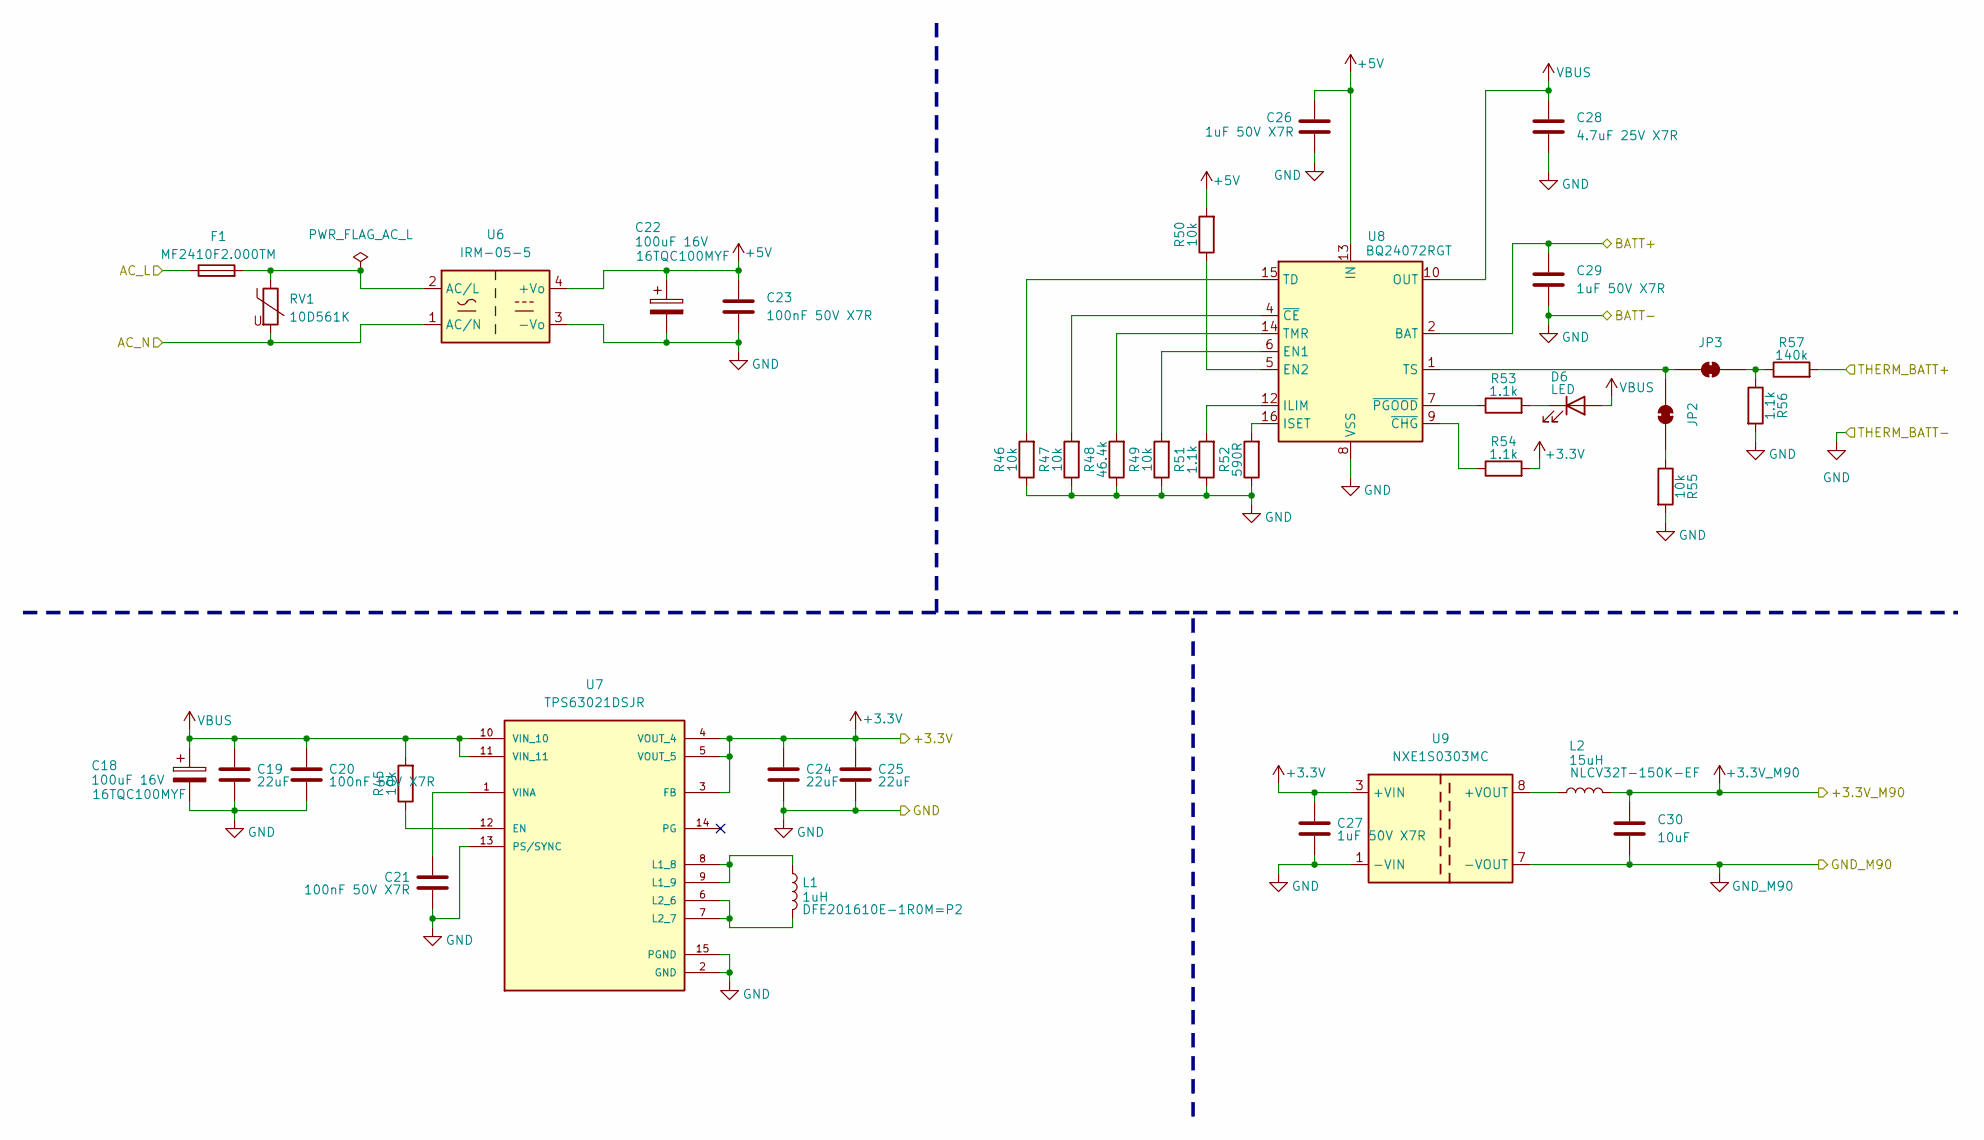
[picture p21: schematic PowerSupply.kicad_sch]

Parts:
C18, C22: 100uF 16V; CP_EIA-7343-31_Kemet-D; Part # 16TQC100MYF; LCSC Part # C7223
C19, C24, C25: 22uF; C_0805_2012Metric; LCSC Part # C45783
C20, C21, C23: 100nF 50V X7R; C_0805_2012Metric; LCSC Part # C49678
C26, C27, C29: 1uF 50V X7R; C_0805_2012Metric; LCSC Part # C28323
C28: 4.7uF 25V X7R; C_0805_2012Metric; LCSC Part # C1779
C30: 10uF; C_0805_2012Metric; LCSC Part # C15850
D6: LED; LED_0805_2012Metric; LCSC Part # C84256
F1: MF2410F2.000TM; Fuse_2410_6125Metric; LCSC Part # C83797
JP2, JP3: SolderJumper_2_Bridged; SolderJumper-2_P1.3mm_Bridged_RoundedPad1.0x1.5mm
L1: 1uH; L_0806_2016Metric; Part # DFE201610E-1R0M=P2; LCSC Part # C161082
L2: 15uH; L_1210_3225Metric_Pad1.42x2.65mm_HandSolder; Part # NLCV32T-150K-EF; LCSC Part # C250232
R45, R46, R47, R49, R50, R55: 10k; R_0805_2012Metric; LCSC Part # C17414
R48: 46.4k; R_0805_2012Metric; LCSC Part # C483162
R51, R53, R54, R56: 1.1k; R_0805_2012Metric; LCSC Part # C185294
R52: 590R; R_0805_2012Metric; LCSC Part # C55566
R57: 140k; R_0805_2012Metric; LCSC Part # C17460
RV1: 10D561K; RV_Disc_D12mm_W6.1mm_P7.5mm; LCSC Part # C2656193
U6: IRM-05-5; Converter_ACDC_MeanWell_IRM-05-xx_THT; LCSC Part # C48603696
U7: TPS63021DSJR; IC_TPS63021DSJR; LCSC Part # C202140
U8: BQ24072RGT; VQFN-16-1EP_3x3mm_P0.5mm_EP1.6x1.6mm; LCSC Part # C140288
U9: NXE1S0303MC; Converter_DCDC_Murata_NXExSxxxxMC_SMD; LCSC Part # C20606969

Connections:
+3.3V: C24.1, C25.1, C27.1, R54.2, U7.3 (FB), U7.4 (VOUT_4), U7.5 (VOUT_5), U9.3 (+VIN); also elsewhere on the board
+3.3V_M90: C30.1, L2.2; also elsewhere on the board
+5V: C22.1, C23.1, C26.1, R50.2, U6.4 (+Vo), U8.13 (IN)
/Connectors/BATT+: C29.1, U8.2 (BAT), U8.3 (BAT); also elsewhere on the board
/Connectors/THERM_BATT+: R57.2; also elsewhere on the board
/Connectors/Ua: F1.1; also elsewhere on the board
GND: C18.2, C19.2, C20.2, C21.2, C22.2, C23.2, C24.2, C25.2, C26.2, C27.2, C28.2, C29.2, R46.1, R47.1, R48.1, R49.1, R51.1, R52.1, R55.2, R56.2, U6.3 (-Vo), U7.2 (GND), U7.13 (PS/SYNC), U7.15 (PGND), U7.16 (GND), U7.17 (GND), U7.18 (GND), U7.19 (GND), U7.20 (GND), U7.21 (GND), U7.22 (GND), U7.23 (GND), U7.24 (GND), U7.25 (GND), U7.26 (GND), U7.27 (GND), U7.28 (GND), U7.29 (GND), U7.30 (GND), U8.8 (VSS), U8.17 (VSS), U9.1 (-VIN); also elsewhere on the board
GND_M90: C30.2, RV1.2, U6.1 (AC/N), U9.7 (-VOUT); also elsewhere on the board
unnamed: D6.1 (K), R53.2
unnamed: JP2.1 (A), R55.1
unnamed: JP2.2 (B), JP3.2 (B), U8.1 (TS)
unnamed: JP3.1 (A), R56.1, R57.1
unnamed: F1.2, RV1.1, U6.2 (AC/L)
unnamed: R45.1, U7.12 (EN)
unnamed: L1.1, U7.8 (L1_8), U7.9 (L1_9)
unnamed: L1.2, U7.6 (L2_6), U7.7 (L2_7)
unnamed: C21.1, U7.1 (VINA)
unnamed: R49.2, U8.6 (EN1)
unnamed: R50.1, U8.5 (EN2)
unnamed: R51.2, U8.12 (ILIM)
unnamed: R52.2, U8.16 (ISET)
unnamed: R46.2, U8.15 (TD)
unnamed: R48.2, U8.14 (TMR)
unnamed: R47.2, U8.4 (~CE)
unnamed: R54.1, U8.9 (~CHG)
unnamed: R53.1, U8.7 (~PGOOD)
unnamed: L2.1, U9.8 (+VOUT)
VBUS: C18.1, C19.1, C20.1, C28.1, D6.2 (A), R45.2, U7.10 (VIN_10), U7.11 (VIN_11), U8.10 (OUT), U8.11 (OUT)
