m-scasserra/TrabajoFinal_MIoT/Hardware/LoRa-Monitor/LoRa-Monitor.kicad_pcb

## KiCad design Hardware/LoRa-Monitor/LoRa-Monitor.kicad_pcb (continued)

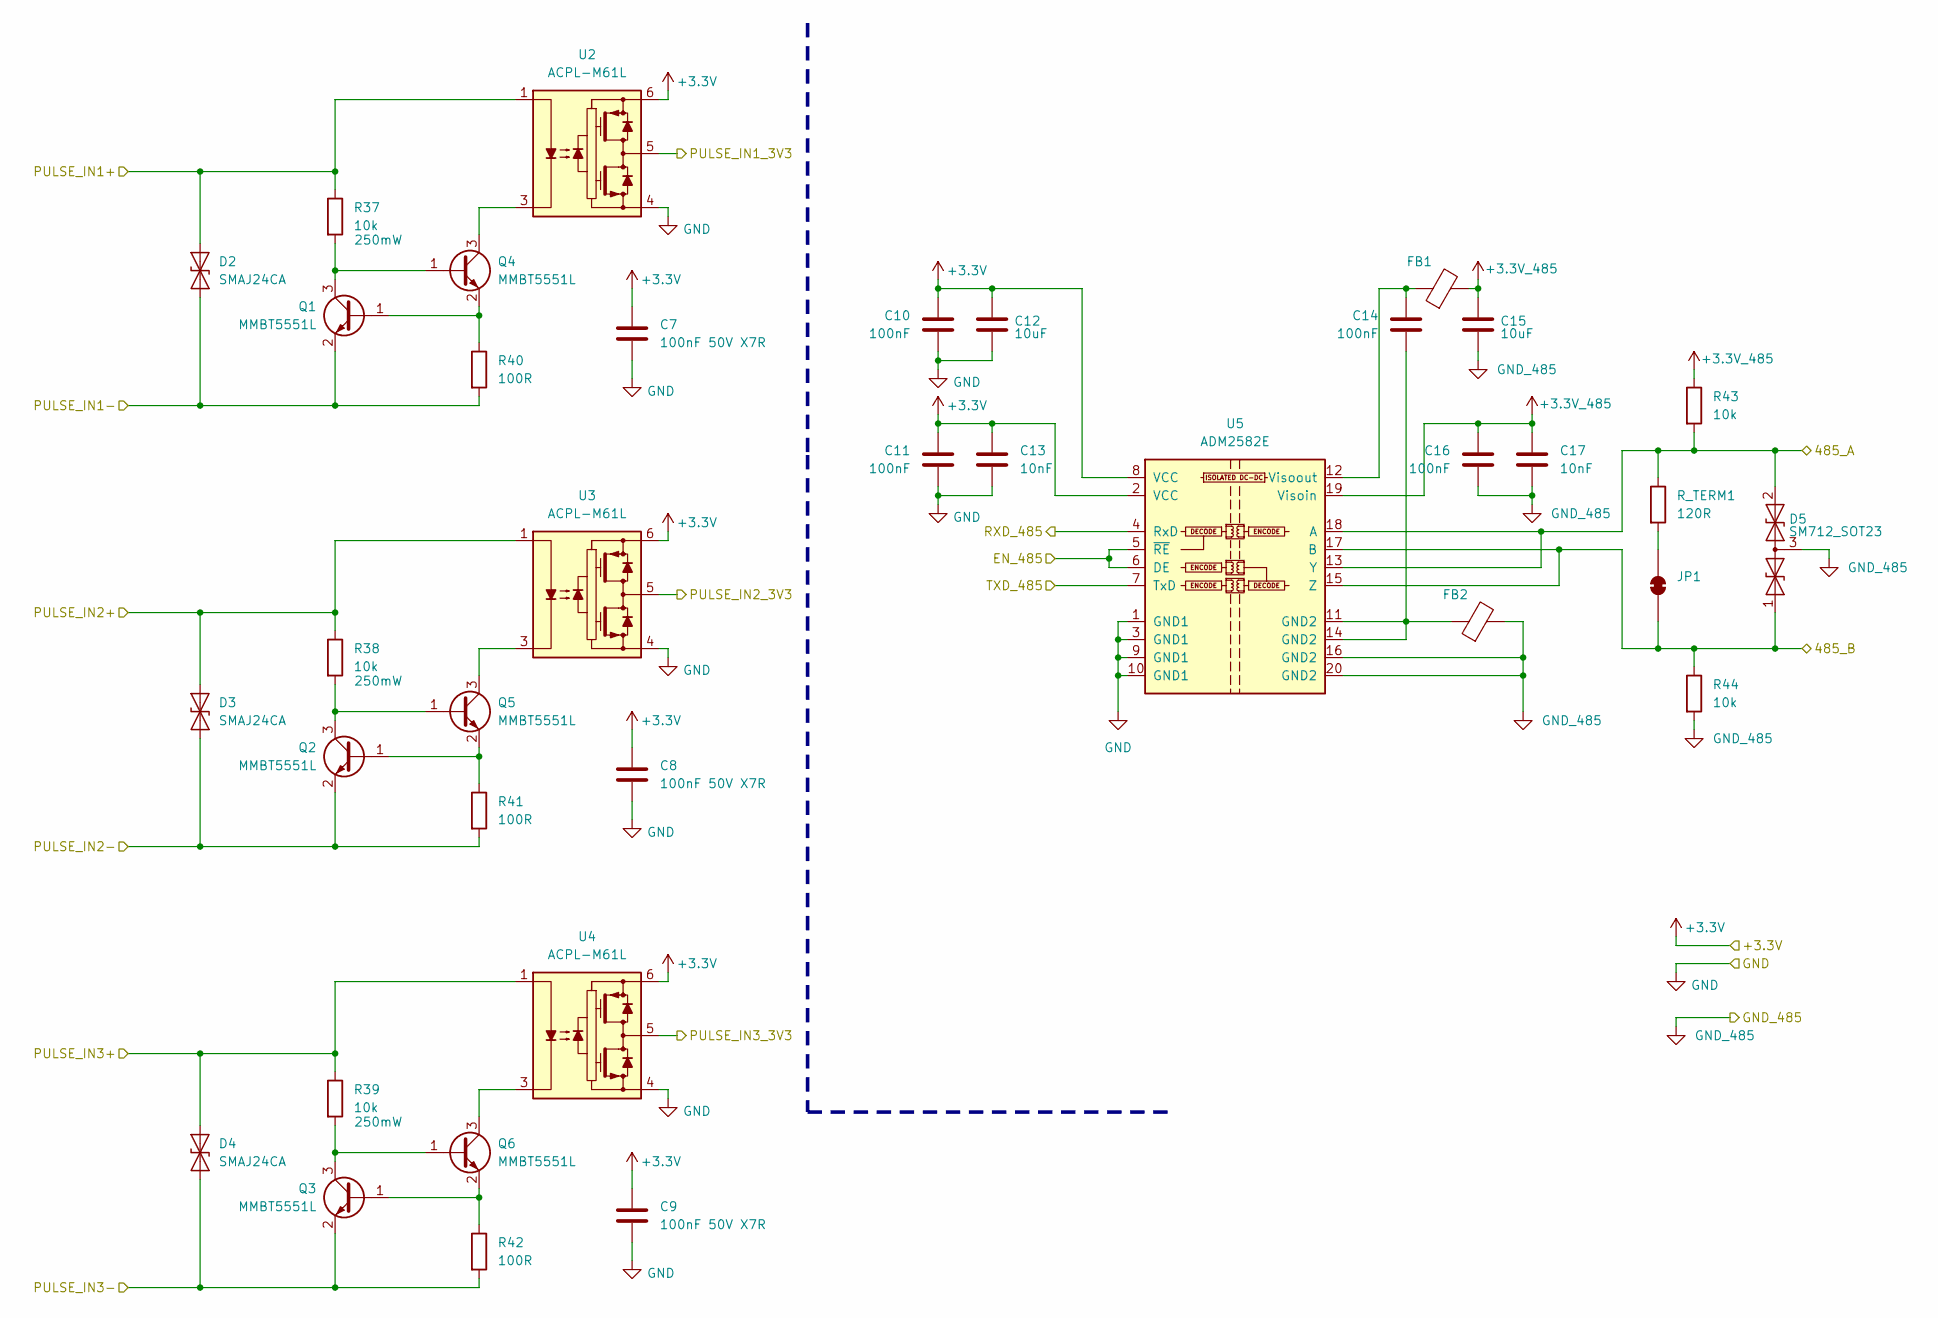
[picture p22: schematic Interfaces.kicad_sch]

Parts:
C7, C8, C9: 100nF 50V X7R; C_0805_2012Metric; LCSC Part # C49678
C10, C11, C14, C16: 100nF; C_0805_2012Metric; LCSC Part # C49678
C12, C15: 10uF; C_0805_2012Metric; LCSC Part # C15850
C13, C17: 10nF; C_0805_2012Metric; LCSC Part # C1710
D2, D3, D4: SMAJ24CA; D_SMA; LCSC Part # C113963
D5: SM712_SOT23; SOT-23; LCSC Part # C521963
FB1, FB2: FerriteBead; L_0603_1608Metric; LCSC Part # C2942905
JP1: SolderJumper_2_Bridged; SolderJumper-2_P1.3mm_Bridged_RoundedPad1.0x1.5mm
Q1, Q2, Q3, Q4, Q5, Q6: MMBT5551L; SOT-23; LCSC Part # C2145
R37, R38, R39: 10k; R_1206_3216Metric; LCSC Part # C17902
R40, R41, R42: 100R; R_0805_2012Metric; LCSC Part # C17408
R43, R44: 10k; R_0805_2012Metric; LCSC Part # C17414
R_TERM1: 120R; R_0805_2012Metric; LCSC Part # C17437
U2, U3, U4: ACPL-M61L; SO-5_4.39x3.84mm_P1.27mm; LCSC Part # C691956
U5: ADM2582E; SOIC-20W_7.5x12.8mm_P1.27mm; LCSC Part # C39494

Connections:
+3.3V: C7.1, C8.1, C9.1, C10.1, C11.1, C12.1, C13.1, U2.6 (VCC), U3.6 (VCC), U4.6 (VCC), U5.2 (VCC), U5.8 (VCC); also elsewhere on the board
+3.3V_485: C15.1, C16.1, C17.1, FB1.2, R43.1, U5.19 (Visoin)
/Connectors/485_A: D5.2 (A2), R43.2, R_TERM1.1, U5.13 (Y), U5.18 (A); also elsewhere on the board
/Connectors/485_B: D5.1 (A1), JP1.1 (A), R44.1, U5.15 (Z), U5.17 (B); also elsewhere on the board
/Connectors/PULSE_IN1+: D2.2 (A2), R37.1, U2.1 (A); also elsewhere on the board
/Connectors/PULSE_IN1-: D2.1 (A1), Q1.2 (E), R40.2; also elsewhere on the board
/Connectors/PULSE_IN2+: D3.2 (A2), R38.1, U3.1 (A); also elsewhere on the board
/Connectors/PULSE_IN2-: D3.1 (A1), Q2.2 (E), R41.2; also elsewhere on the board
/Connectors/PULSE_IN3+: D4.2 (A2), R39.1, U4.1 (A); also elsewhere on the board
/Connectors/PULSE_IN3-: D4.1 (A1), Q3.2 (E), R42.2; also elsewhere on the board
/Energy Meter Interface Module/EN_485: U5.5 (~RE), U5.6 (DE); also elsewhere on the board
/Energy Meter Interface Module/PULSE_IN1_3V3: U2.5 (VO); also elsewhere on the board
/Energy Meter Interface Module/PULSE_IN2_3V3: U3.5 (VO); also elsewhere on the board
/Energy Meter Interface Module/PULSE_IN3_3V3: U4.5 (VO); also elsewhere on the board
/Energy Meter Interface Module/RXD_485: U5.4 (RxD); also elsewhere on the board
/Energy Meter Interface Module/TXD_485: U5.7 (TxD); also elsewhere on the board
GND: C7.2, C8.2, C9.2, C10.2, C11.2, C12.2, C13.2, U2.4 (VEE), U3.4 (VEE), U4.4 (VEE), U5.1 (GND1), U5.3 (GND1), U5.9 (GND1), U5.10 (GND1); also elsewhere on the board
GND_485: C15.2, C16.2, C17.2, D5.3 (common), FB2.2, R44.2, U5.16 (GND2), U5.20 (GND2); also elsewhere on the board
unnamed: C14.2, FB2.1, U5.11 (GND2), U5.14 (GND2)
unnamed: JP1.2 (B), R_TERM1.2
unnamed: Q1.1 (B), Q4.2 (E), R40.1
unnamed: Q1.3 (C), Q4.1 (B), R37.2
unnamed: Q2.1 (B), Q5.2 (E), R41.1
unnamed: Q2.3 (C), Q5.1 (B), R38.2
unnamed: Q3.1 (B), Q6.2 (E), R42.1
unnamed: Q3.3 (C), Q6.1 (B), R39.2
unnamed: Q4.3 (C), U2.3 (C)
unnamed: Q5.3 (C), U3.3 (C)
unnamed: Q6.3 (C), U4.3 (C)
unnamed: C14.1, FB1.1, U5.12 (Visoout)

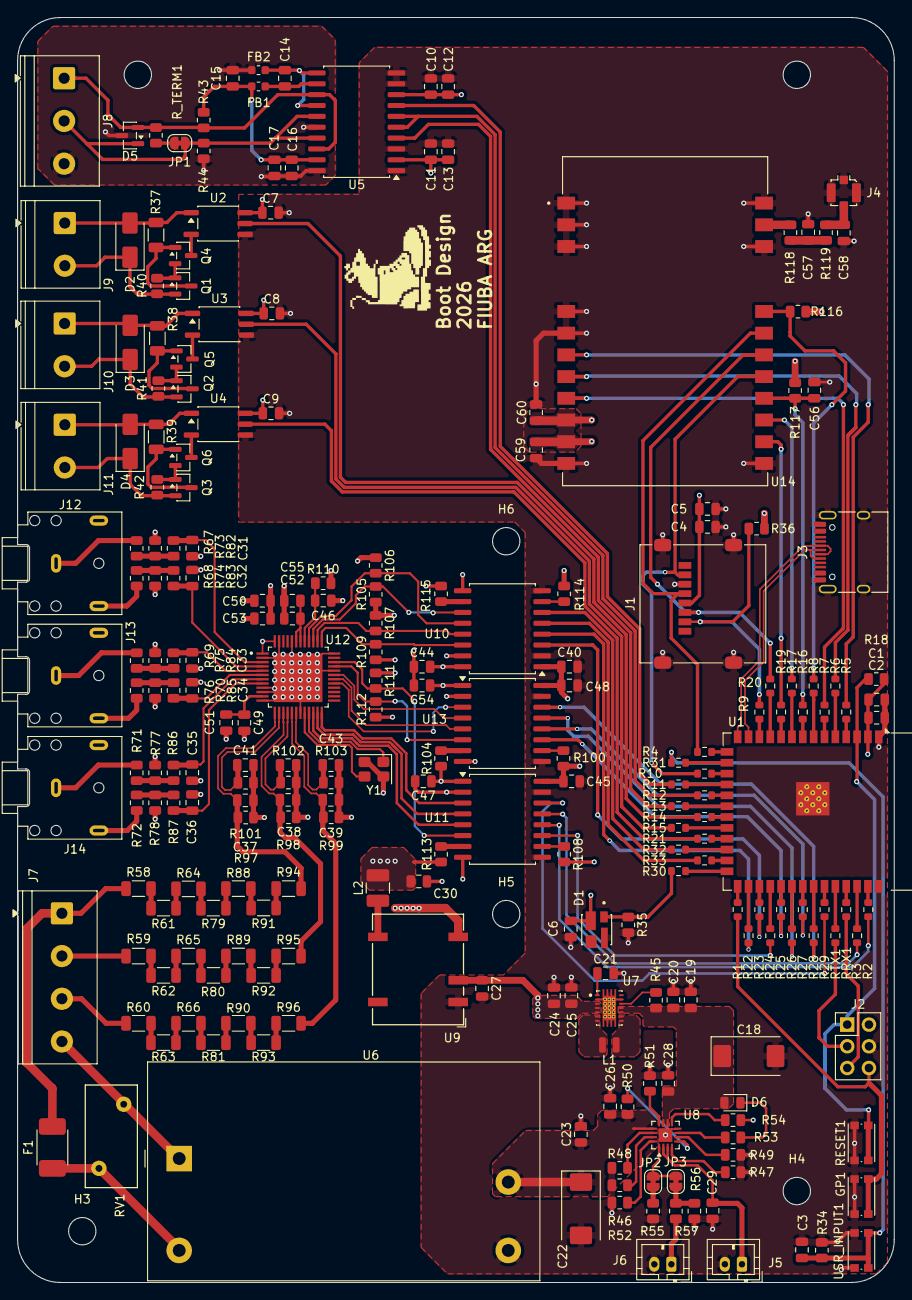
[picture p23: board LoRa-Monitor.kicad_pcb from above]

Board: 4 copper layers, 102.6 x 148.0 mm, 241 parts (0 on the bottom side), 191 nets.
