m-scasserra/TrabajoFinal_MIoT/(commit log)

2026-06-03 Add LED driver implementation with CMake configuration and interface
2026-06-03 Add test application files including CMake configuration, test cases, and pytest integration for LED functionality
2026-06-03 Add main application file and CMake configuration for LED control
2026-06-08 Added hardware files and updated gitihone
    [Connectors.kicad_sch, Interfaces.kicad_sch, LoRa-Monitor.kicad_pcb, LoRa-Monitor.kicad_sch, MCU.kicad_sch, PowerSupply.kicad_sch, Sensors.kicad_sch]
2026-06-08 Deleted lck files
    [LoRa-Monitor.kicad_sch]
2026-06-08 Fixed Power and Ground on the Interface nodes
    [Interfaces.kicad_sch, PowerSupply.kicad_sch]
2026-06-09 Added PSU
    [Interfaces.kicad_sch, LoRa-Monitor.kicad_pcb, MCU.kicad_sch, PowerSupply.kicad_sch]
2026-06-09 Added more PSU components.
    [IRM-05-5--3DModel-STEP-56544.STEP, LoRa-Monitor.kicad_pcb, PowerSupply.kicad_sch, TPS63021DSJR.step]
2026-06-10 Finished PSU module, started Energy meter
    [ATM90E32AS-AU-R.step, EnergyMeter.kicad_sch, Interfaces.kicad_sch, LoRa-Monitor.kicad_pcb, LoRa-Monitor.kicad_sch, PowerSupply.kicad_sch]
2026-06-10 Finished Energy Meter Module, started LoRa Module and MCU.
    [Connectors.kicad_sch, E22-900M30S.step, EnergyMeter.kicad_sch, LoRa-Monitor.kicad_sch, LoRaModule.kicad_sch, MCU.kicad_sch]
2026-06-10 Finished MCU and Lora modules. Finished Connectors sheet
    [Connectors.kicad_sch, EnergyMeter.kicad_sch, LoRa-Monitor.kicad_sch, LoRaModule.kicad_sch, MCU.kicad_sch, SK6812MINI-012.step]
2026-06-11 Finished schematic, started with PCB design
    [Connectors.kicad_sch, EnergyMeter.kicad_sch, Interfaces.kicad_sch, LoRa-Monitor.kicad_pcb, LoRa-Monitor.kicad_sch, LoRaModule.kicad_sch, MCU.kicad_sch, PowerSupply.kicad_sch]
2026-06-11 Started routing.
    [Connectors.kicad_sch, EnergyMeter.kicad_sch, Interfaces.kicad_sch, LoRa-Monitor.kicad_pcb, LoRa-Monitor.kicad_sch, PowerSupply.kicad_sch]
2026-06-12 Finished the first component disposition
    [Connectors.kicad_sch, EnergyMeter.kicad_sch, LoRa-Monitor.kicad_pcb, MCU.kicad_sch]
2026-07-07 Fixed schematics and started layout
    [EnergyMeter.kicad_sch, LoRa-Monitor.kicad_pcb, MCU.kicad_sch, sensors.kicad_sch]
2026-07-15 Finished routing and DRC gives 0 errors.
    [472192001.stp, 734120110.stp, Connectors.kicad_sch, EnergyMeter.kicad_sch, LoRa-Monitor.kicad_pcb, PowerSupply.kicad_sch, TYPE-C-31-M-12--3DModel-STEP-56544.STEP, WE-GF_1210_2+%28rev1%29.stp]
2026-07-21 Added pruductions files (gerbers, BOM and CPL file).
    [bom.csv, designators.csv, positions.csv]
2026-07-21 Added parameters for the productions files, changed components on LCSC to reduce the price of BoM, minimal changes on the routing.
    [Connectors.kicad_sch, EnergyMeter.kicad_sch, Interfaces.kicad_sch, LoRa-Monitor.kicad_pcb, LoRaModule.kicad_sch, MCU.kicad_sch, PowerSupply.kicad_sch]
2026-07-23 Added SPI bus controller component.
2026-07-23 Changed vias min vias hole to be 0.2mm and vias size to be 0.4mm. Regenerated production files.
    [LoRa-Monitor.kicad_pcb, bom.csv, designators.csv, positions.csv]
2026-07-23 Created CMakeLists.txt for the lorawan component and changed directory structs. Implementation oif the sx126xboard.c with the ESP-IDF functions and SPI controller component bridge.
2026-07-28 First working port of the LoRaWAN stack on the ESP32.
2026-08-06 Added DTOs for the gateways backend. Added Chirpstack.Api and Grpc client to the deps. Stil have to modify de DB for the new gateway table.
2026-08-11 Added gateway services and its relevants endpoints. Added Nodes services and its endpoints. Added Device Profile services and its endpoints. Reformulated the Database schema for the nodes, gateways a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
2026-08-12 Added typed version for the DeviceRow
2026-08-12 Removed NuGet package for Chirpstack.Api and generated the Chirpstack API from the Proto GRPC because the NuGet package was an older version than the current Chirpstack.
2026-08-13 Added first draft for the deviceprofile frontend.
2026-08-13 Second iteration of the device profile page.
2026-08-18 Fixed Node device profile not being an Guid. Added Node row and parse for the DTO. Added node provisioning and endpoints for it.
2026-08-18 Added supports for the endpoints until now. This includes, gateways, deviceprofiles and nodes. Added common types to types.ts
2026-08-18 Finished device profile crud and frontpage
2026-08-18 Fixed Devices Profiles
2026-09-14 Changed the RS485-TTL translator and its relevent componentes (Power source and optocuplers) for a simpler and easier solution using the ADM2582.
    [Connectors.kicad_sch, EnergyMeter.kicad_sch, Interfaces.kicad_sch, LoRa-Monitor.kicad_pcb, LoRa-Monitor.kicad_sch, LoRaModule.kicad_sch, MCU.kicad_sch, PowerSupply.kicad_sch]
